MaltWhiskey/Mega-Cube/Software/LED Display/sd/Cat-meowing.jpg

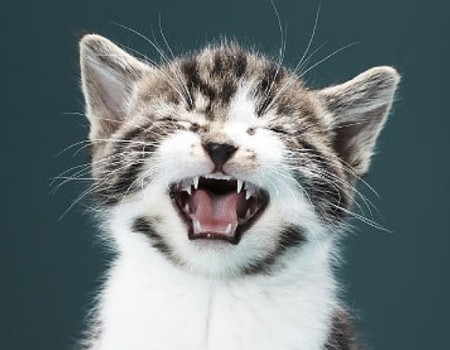
Software/LED Display/sd/Cat-meowing.jpg
