MaltWhiskey/Mega-Cube/Software/LED Display/sd/Cute-kittens.jpg

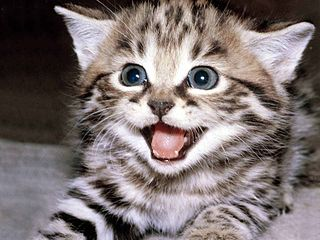
Software/LED Display/sd/Cute-kittens.jpg
