MaltWhiskey/Mega-Cube/README.md

# Mega-Cube
16x16x16 PL9823 Cube with Teensy 4.0 and FlexIO driver
https://youtu.be/ciaFar8nfHc
