MaltWhiskey/Mega-Cube/Documents/JIG.jpg

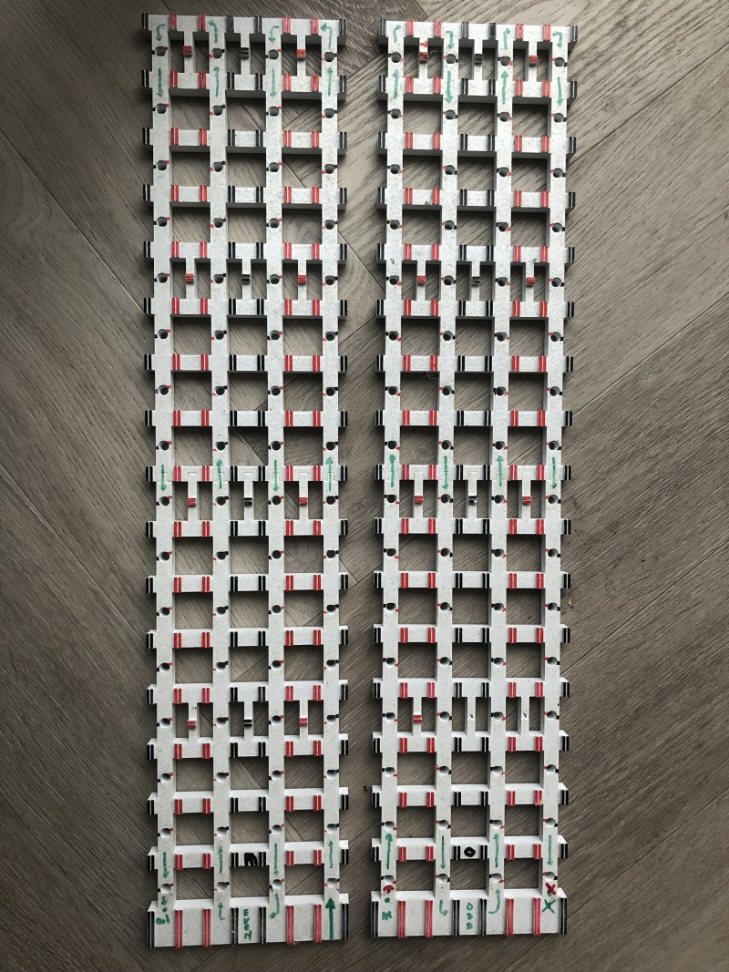
Documents/JIG.jpg
