MaltWhiskey/Mega-Cube/graphics/Sprites/Mario Sprite Sheet.png

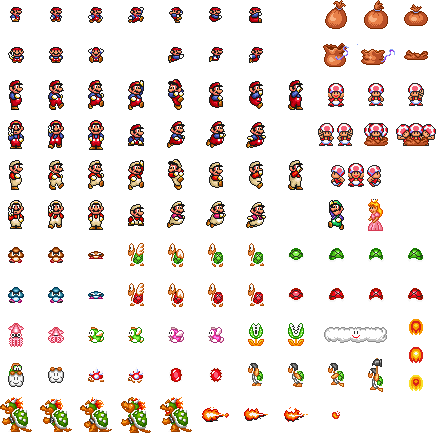
graphics/Sprites/Mario Sprite Sheet.png
