MaltWhiskey/Mega-Cube/Construction/1 Tower box.stl

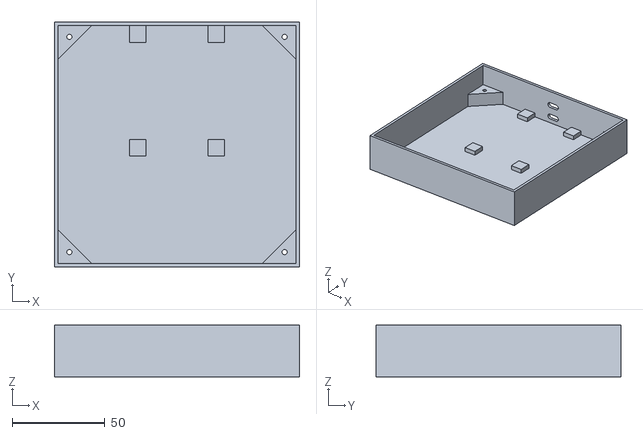
[picture p5: CAD file, 2022-07-15]
Construction/1 Tower box.stl
132.0 x 132.0 x 28.0
