MaltWhiskey/Mega-Cube/Construction/PCB.stl

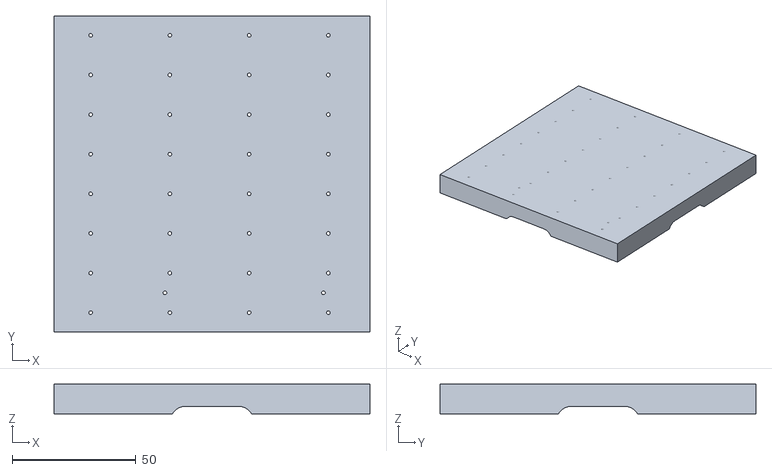
[picture p6: CAD file, 2021-11-05]
Construction/PCB.stl
127.6 x 127.6 x 12.0
