MaltWhiskey/Mega-Cube/Construction/Lid Thicker.stl

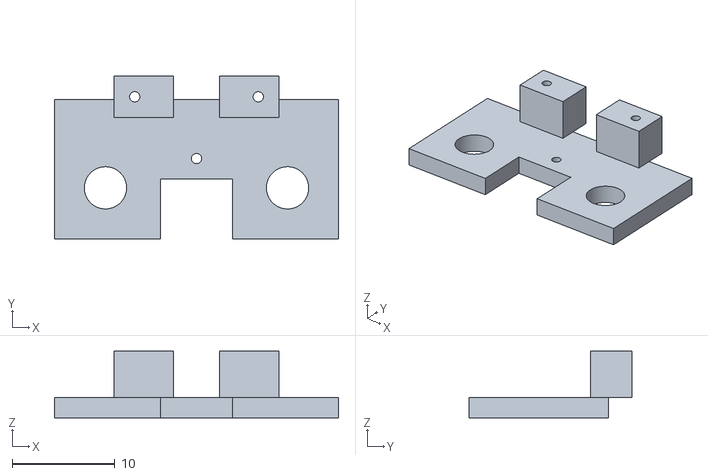
[picture p7: CAD file, 2021-11-04]
Construction/Lid Thicker.stl
27.6 x 15.8 x 6.50
