MaltWhiskey/Mega-Cube/Construction/Box Border.stl

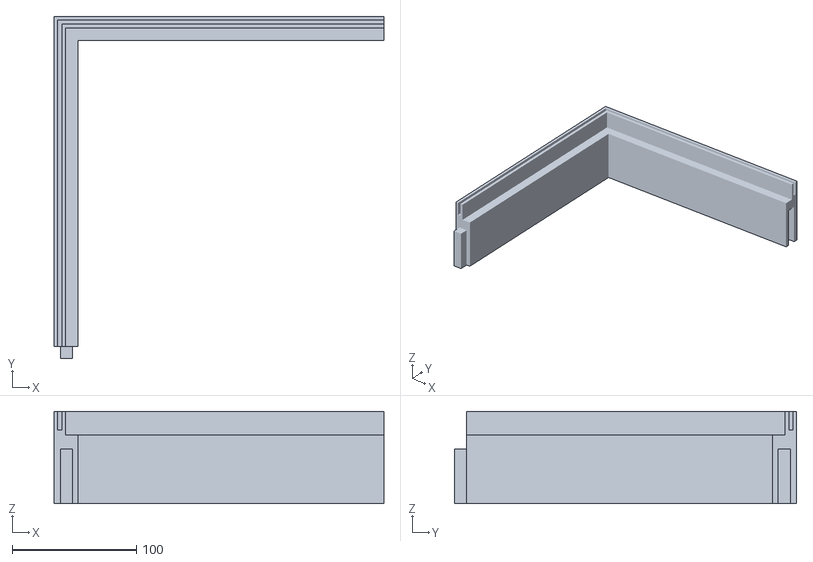
[picture p8: CAD file, 2021-11-04]
Construction/Box Border.stl
265.3 x 275.2 x 74.0
