MaltWhiskey/Mega-Cube/Construction/Clip.stl

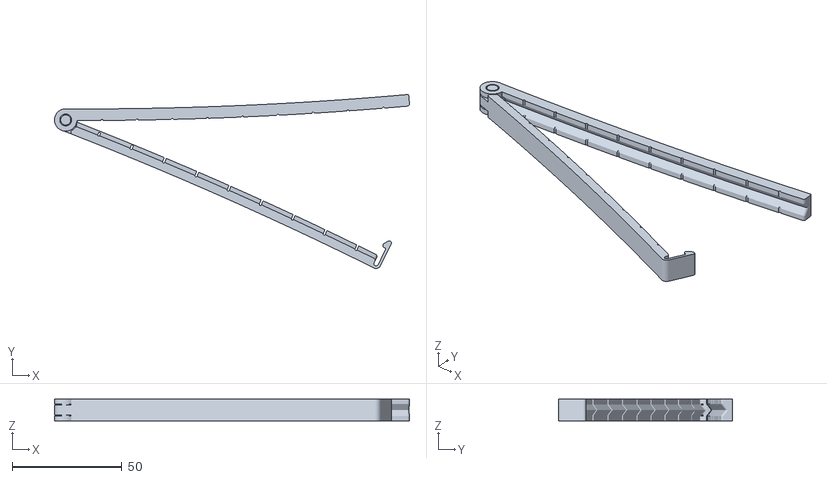
[picture p9: CAD file, 2021-11-04]
Construction/Clip.stl
161.5 x 79.1 x 10.0
