MaltWhiskey/Mega-Cube/Construction/Lid flat.stl

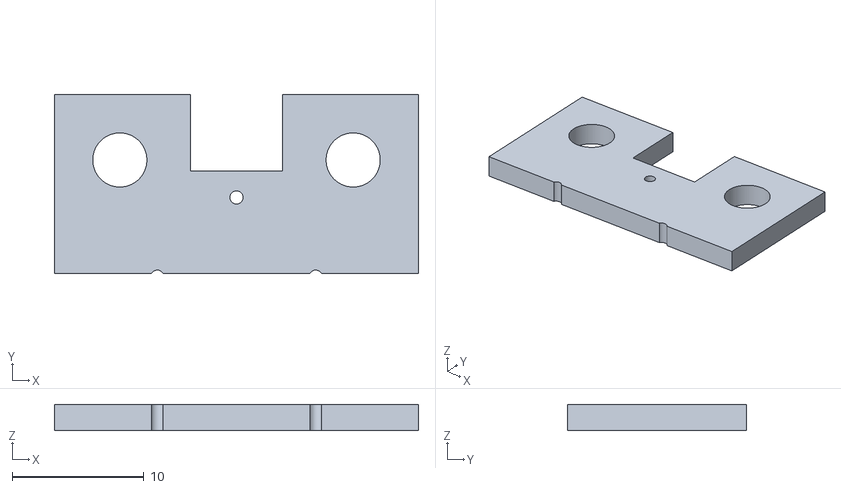
[picture p10: CAD file, 2021-11-04]
Construction/Lid flat.stl
27.6 x 13.5 x 2.00
