MaltWhiskey/Mega-Cube/Construction/Jig Bottom A.stl

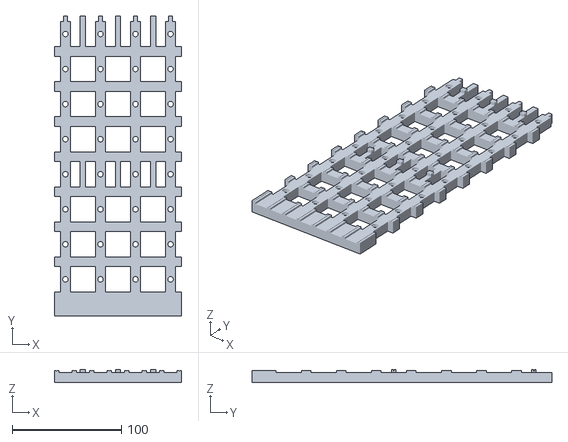
[picture p11: CAD file, 2021-11-04]
Construction/Jig Bottom A.stl
116.0 x 274.0 x 11.9
