MaltWhiskey/Mega-Cube/Construction/BendBox.stl

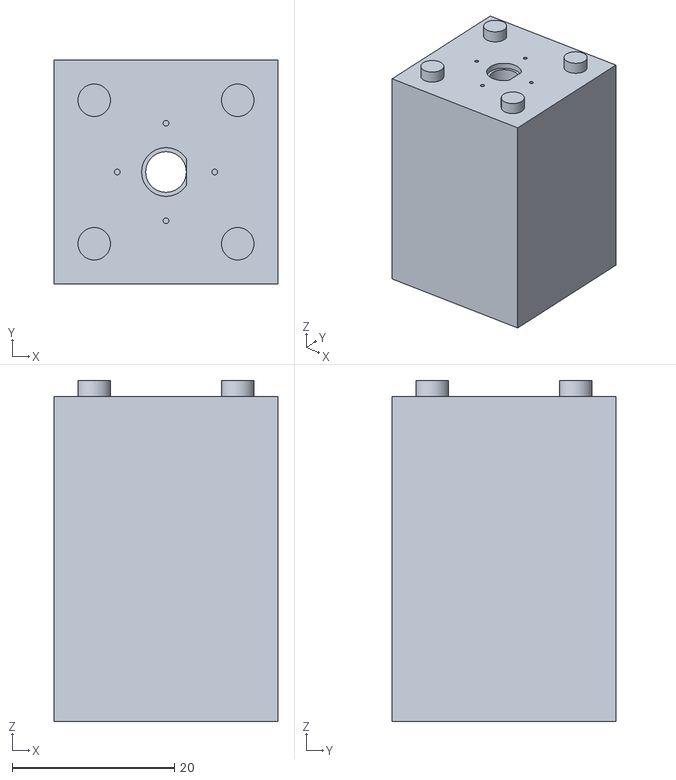
[picture p12: CAD file, 2021-11-04]
Construction/BendBox.stl
27.6 x 27.6 x 42.0
