MaltWhiskey/Mega-Cube/Construction/Jig Top A.stl

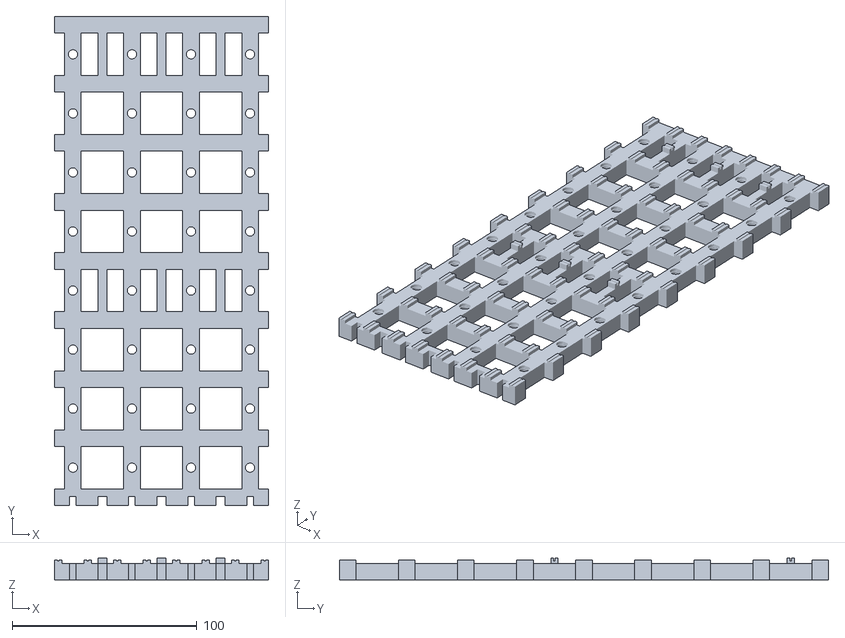
[picture p13: CAD file, 2021-11-04]
Construction/Jig Top A.stl
116.0 x 265.0 x 11.9
