MaltWhiskey/Mega-Cube/Construction/Box Border (2).stl

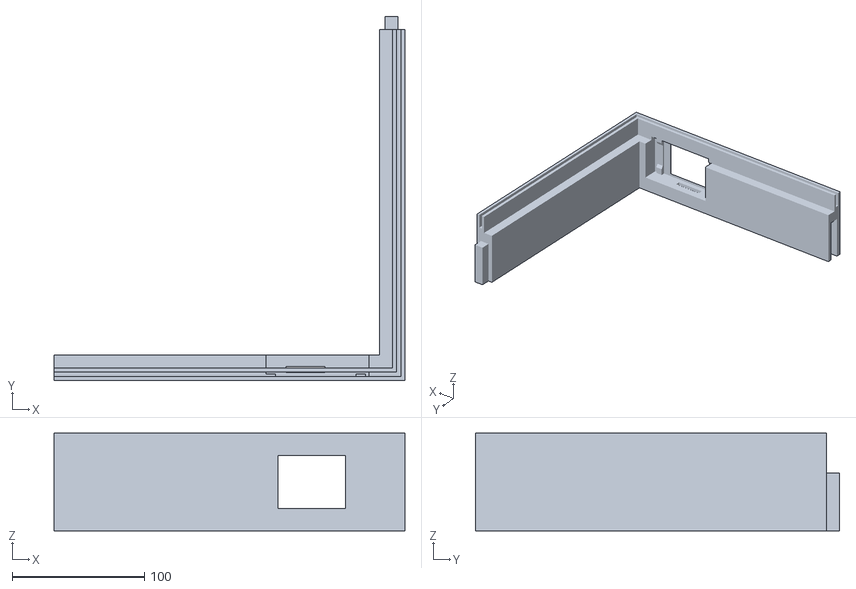
[picture p14: CAD file, 2021-11-04, an earlier design]
Construction/Box Border (2).stl
265.3 x 275.2 x 74.0
