MaltWhiskey/Mega-Cube/(list of files, cad)

Other CAD files:
Construction/Jig Bottom B.stl
Construction/Jig Top B.stl
Construction/Box Border (3).stl
Construction/Box Border (1).stl
