MaltWhiskey/Mega-Cube/Software/LED Display/todo.txt

power/Graphics.h
    look at asm for faster graphics drawing
    make a class friend of display
    fix wifi (hardware noise problem only this board)
core/LCD.*
    Implement LCD with vindar Library
    println Logging to wio terminal (noise problem)
space/
    pong scores + fading in after destruction
    clock

    ---------------------------------------
    HARDWARE:

    SOFTWARE:
        copy config from infinity, but skip json stuff.
        Pong.h needs checking
        Spectrum.h needs checking
        Cube.h is new
