MaltWhiskey/Mega-Cube/(threads)

Thread 2 (2021-11-14):

Components

TallKid420, 2021-11-14:
Can you please give me the order links to everything thanks

khan-pog, 2021-11-14:
Hello here is a couple links to what i have found for PCB components.

ESP8266:
https://core-electronics.com.au/wifi-module-esp8266-4mb.html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

Teensy-4.0:
https://core-electronics.com.au/teensy-4-0.html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

Voltage regulator:
https://www.ebay.com.au/itm/304129516747?itemid=304129516747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

2.4 inch screen and sd card.
https://www.ebay.com.au/itm/322638960113

Addressable LED WS2811:
https://de.aliexpress.com/item/32832099662.html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

TallKid420, 2021-11-14:
Thank you for sending these it helped a lot

MaltWhiskey, 2021-11-14:
Get pl9823 5mm leds not ws281x unless you first test a few and they work without capacitor.
The pcb has an assembly file, it’s in excel format for windows or numbers for ios. If you use the assembly file with assembly service the fab company will assemble the board for you with the components placed. The kicad project will also reveal all connectors and components used, there are no secrets here.
I used silvered copper wire 0.8mm, but copper will be fine too. If you don’t have a draw plate, get 0.6 or 0.65 mm instead.
12 AWG silicone wire, xt60 connectors. (Use what you like, there is only around 16A each tower so xt60 is overkill, but i like them a lot better than xt30.
The screen is ili9341 2.4”.
The connectors are for nixitube sockets, they are a bit bigger than pin headers.

If you are going to make this COOL!!!

Closed 2022-03-21.

Thread 3 (2021-11-22):

License?

firstorderexperiment, 2021-11-22:
Hello, is there a license for the code, or can you please add one?

Great work by the way. Loved the visuals on YouTube.

MaltWhiskey, 2021-11-22:
You can do whatever you want with it. There is one piece of code with Perlin Noise (you don’t have to use it) i’m not sure if there are limitations on that (i put credit in the source code) All other stuff is made by me, so enjoy!

Closed 2022-03-21.

Thread 5 (2022-01-01):

Data wire

khan-pog, 2022-01-01:
Hello, sorry for the ignorant question however here it is. Would it be okay to use 0.7mm wire as a data single wire? (I have a lot of 0.7mm wire)

MaltWhiskey, 2022-01-01:
From a signal standpoint it doesn’t matter. I used .22mm and .20mm because any thinner would break easily. But I recommend as thin as possible because it will obstruct the view through the cube a bit.

Op 1 jan. 2022 om 15:47 heeft khan-pog ***@***.***> het volgende geschreven:

Hello, sorry for the ignorant question however here it is. Would it be okay to use 0.7mm wire as a data single wire? (I have a lot of 0.7mm wire)

—
Reply to this email directly, view it on GitHub<https://github.com/MaltWhiskey/Mega-Cube/issues/5>, or unsubscribe<https://github.com/notifications/unsubscribe-auth/AKYMZ5UMWVPR5TNRAUQ6VGLUT4HYHANCNFSM5LCRYE2A>.
You are receiving this because you are subscribed to this thread.Message ID: ***@***.***>

Closed 2022-03-21.

Thread 7 (2023-08-20):

Affiliate links

brandonfake69, 2023-08-20:
I understand you don't want to provide a kit (given the huge upfront investment in the items you'd have to make) but I'd still love to get a more detailed list of items since I am quite new to the hardware stuff. On AliExpress, for instance, there are a lot of results for "pl9823". Have you considered adding affiliate links to this repo (and your YouTube channel)? At ~$400 USD for just the lights you could make a killing since people would buy stuff to make for not just this but other projects they have in mind (AliExpress has an affiliate program that pays 9%). I'd certainly buy through your links since you've been kind enough to provide this repo and videos. You could also link to the power supplies, wire, acrylic (I'd even buy a pre-made acrylic box if you link to one), the filament used to make the 3d printed parts, etc.

EDIT: I think you should put all of this links in the README.md so it's easy for people to find. You can even include links for the soldering iron, mat, wire, solder, wire cutters/crimpers, your 3d printer, etc. that you use since I don't have a lot of that stuff. Even if I don't intend to build a massive cube for my first project this helps out a newb like myself on the tools to get.

Thanks!

MaltWhiskey, 2023-08-27:
Hi Brandon?There quite a few people that made or are making my cube, so that affiliate linking may no be such a bad thing, considering it’ll help people finding the right stuff… I’ll look into it.I found some cheaper led’s than the PL9823 also more energy efficient. I have used these so i can recommend them. Here is a non affiliated link for you:https://a.aliexpress.com/_EGUFXldKind Regards,DaniëlOp 20 aug. 2023 om 03:01 heeft brandonfake69 ***@***.***> het volgende geschreven:
I understand you don't want to provide a kit (given the huge upfront investment in the items you'd have to make) but I'd still love to get a more detailed list of items since I am quite new to the hardware stuff. On AliExpress, for instance, there are a lot of results for "pl9823". Have you considered adding affiliate links to this repo (and your YouTube channel)? At ~$400 USD for just the lights you could make a killing (AliExpress has an affiliate program that pays 9%). I'd certainly buy through your links since you've been kind enough to provide this repo and videos. You could also link to the power supplies, wire, acrylic (I'd even buy a pre-made box if you link to one), the filament used to make the 3d printed parts, etc.
Thanks!

—Reply to this email directly, view it on GitHub, or unsubscribe.You are receiving this because you are subscribed to this thread.Message ID: ***@***.***>

devoh747, 2023-08-28:
The link to the LEDs didn't work for me.

On Sun, Aug 27, 2023 at 12:58 PM Malt Whiskey ***@***.***>
wrote:

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

brandonfake69, 2023-08-28:
There's a missing space. Just remove the "Kind" from the end of the URL.

brandonfake69, 2023-09-27:
Hi,
Any progress on this? I’d love to get started and give you some of that sweet sweet affiliate revenue. I tested the top hat LEDs you linked to and they seem to work great. Also, I thought I saw a comment on one of your videos about using resistors but I couldn’t see where they were used. What value and how many did you use?

MaltWhiskey, 2023-09-27:
I signed up for the affiliate program, but decided not to use it. The reason is the suppliers that i would recommend are not part of the affiliate program. So i can't generate affiliate links for them. There are suppliers that are in the affiliate program, but they are a lot more expensive and if i wouldn't buy from them myself i can't recommend them.

There are resistors on the pcb (the real one, not the 3d printed), the values/components are in the assembly file. No need to worry about them unless you make the wires to the led channels a lot longer. They are needed to suppress transients and reflections.

Althepeoplespal, 2023-11-09:
Do you recommend the round or hat version of the WS2811 leds? Are there any other changes or updates that you've done to this project that may help while I'm in the planning stages of building this cube?

Pax-IT, 2024-01-18:
Because I'm late to the party, the link: https://a.aliexpress.com/_EGUFXld does not work anymore, I'm also looking which LEDs you used. Is it possible you update your README.md and at the parts you used, not links but types and other numbers that can be helpful?

And maybe to get some revenue add a buy me coffee or patreon link.

Closed 2023-09-29.

Thread 8 (2024-02-24):

Box Border to small and Tower Box to tall

Alendres, 2024-02-24:
Hello do you can give me the cad data because the box boarder ist to small and the Tower Box ist to tall for the PCB

MaltWhiskey, 2024-02-25:
You need to glue together all 4 box borders and put the 16 pcb inside. The 1 tower box is not needed.

Op 24 feb 2024 om 20:46 heeft Alendres ***@***.***> het volgende geschreven:

Hello do you can give me the cad data because the box boarder ist to small and the Tower Box ist to tall for the PCB

—
Reply to this email directly, view it on GitHub<https://github.com/MaltWhiskey/Mega-Cube/issues/8>, or unsubscribe<https://github.com/notifications/unsubscribe-auth/AKYMZ5RD7YT3FJH6S2SDLFDYVI7SHAVCNFSM6AAAAABDYHSTUKVHI2DSMVQWIX3LMV43ASLTON2WKOZSGE2TENBWGAYDGMI>.
You are receiving this because you are subscribed to this thread.Message ID: ***@***.***>

freudecellier35, 2024-04-06:
bonjour. est t il possible d avoir les quantité de PCB a fabriquer et si vous avez un lien eventuelement pour les commander et la liste des composent et materiel a commander que j essai de construire votre cube . un grand merci car il est cool

Thread 10 (2024-04-23):

LED Tower PCB

AndrewBunn00, 2024-04-23:
Hello!
I'm making the Mega Cube currently, and would love to see some photos of the underside of one of the 16 pcb's for the towers. In the video, you show the underside of a completed one but it doesn't appear to match the final design you settled on (which the wiring is shown as a drawing right after). I'm newer to the hardware/electrical side of things, so a photo showing how things were laid out and what wire was used in the final design would be much appreciated :)

If you're curious, I've made 2 ladders of led's and am starting 2 more now. Wanting to get the first pcb finished so I can hook it up and test the first tower!
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

MaltWhiskey, 2024-04-23:
[image0.jpeg]
Using stranded wire (i think 14 awg) is much easier than solid core. Be mindful of the  isolation as to not short the circuit. You don’t need the dupont wire. Measure how long you want the wire with the xt-60 connector, it needs to get to the underside of the big aluminium plate (or what ever you used) and connect to a matching xt-60 connected to a psu.

Op 23 apr 2024 om 02:50 heeft Andrew Bunn ***@***.***> het volgende geschreven:

Hello!
I'm making the Mega Cube currently, and would love to see some photos of the underside of one of the 16 pcb's for the towers. In the video, you show the underside of a completed one but it doesn't appear to match the final design you settled on (which the wiring is shown as a drawing right after). I'm newer to the hardware/electrical side of things, so a photo showing how things were laid out and what wire was used in the final design would be much appreciated :)

If you're curious, I've made 2 ladders of led's and am starting 2 more now. Wanting to get the first pcb finished so I can hook it up and test the first tower!
IMG_1034.jpeg (view on web)<https://github.com/MaltWhiskey/Mega-Cube/assets/89755834/f99902bd-535a-4a67-9c9d-19c9fd6a0edb>

—
Reply to this email directly, view it on GitHub<https://github.com/MaltWhiskey/Mega-Cube/issues/10>, or unsubscribe<https://github.com/notifications/unsubscribe-auth/AKYMZ5W7TTVP2DIE4VWASF3Y6WV53AVCNFSM6AAAAABGTY2YSGVHI2DSMVQWIX3LMV43ASLTON2WKOZSGI2TONZQGQYDIMA>.
You are receiving this because you are subscribed to this thread.Message ID: ***@***.***>

AndrewBunn00, 2024-04-23:
It looks like the image didn't upload successfully ([image0.jpeg]). Would appreciate a reupload :) And I went with an aluminum plate as well, my goal is to follow what you did as close as possible.

MaltWhiskey, 2024-04-23:
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

MaltWhiskey, 2024-04-23:
I recommend using color coded jst rcy 2 pin connectors for the led channels (don’t use dupont). Makes sorting wires a lot easier.

Closed 2024-04-23.

Thread 13 (2025-01-17):

Allow for thicker wire in the jig

brandonfake69, 2025-01-17:
I saw in one of your YouTube comments that you thought the wire you used was too small in diameter. When I tried thicker wire it wouldn’t fit in the jigs without forcing it and therefore bending the wire. I attempted to make the wire grooves in the jig wider but it didn’t turn out well since I am not familiar with the software to do it. I thought it would be good to have that change to the jigs in the repo anyway and would like to request it. Thank you for this project!

brandonfake69, 2025-05-15:
I had ChatGPT give it a try but the outcome was [pretty funny](https://files09.oaiusercontent.com/file-72QMCpTe6ECMQEKYndBHCN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)

brandonfake69, 2025-05-15:
Grok doesn't know how to deal with .stl files. Claude gives me an error "Conversation is 3956% over the [length limit](https://support.anthropic.com/en/articles/7996848-how-large-is-claude-s-context-window). Try replacing the attached file with smaller excerpts."

Perhaps there's another LLM that is capable of it? I was hoping something like this https://www.youtube.com/watch?v=ytomieYqUCQ would work since we have an even better Gemini version available now.

MaltWhiskey, 2025-05-16:
You can do this in the slicer. Hole horizontal expansion or something similar depending on the slicer used.

Closed 2025-05-21.
