MaltWhiskey/Mega-Cube/Electronics/Mega-Cube-Board/Documents/TPS54331 WBDesign.pdf

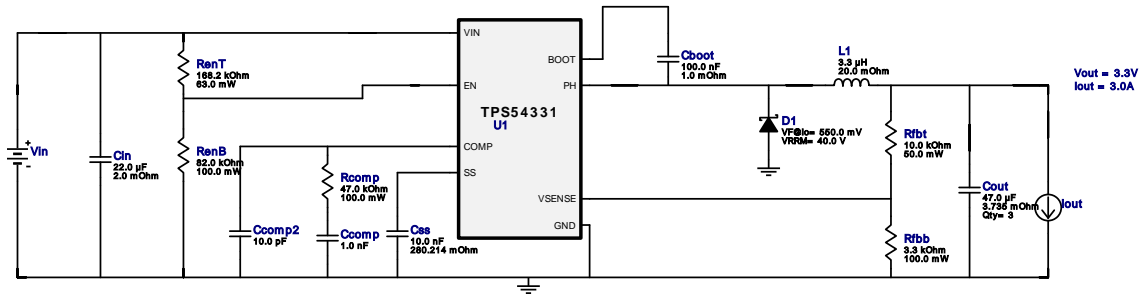
[picture p15: figure]
Css 10.0 nF 280.214 m Ohm; Ccom p2 10.0 pF; TPS5 4 3 3 1; BOOT; VIN; VSENSE; COMP; GND; Rfbb 3.3 kOhm 100.0 m W; RenB 82.0 kOhm 100.0 m W; RenT 168.2 kOhm 63.0 m W; Cboot 100.0 nF 1.0 m Ohm; Cin 22.0 µF 2.0 m Ohm; L1 3.3 µH 20.0 m Ohm; Rfbt 10.0 kOhm 50.0 m W; Cout 47.0 µF 3.735 m Ohm Qty= 3; D1 VF@Io= 550.0 m V VRRM= 40.0 V; Ccom p 1.0 nF; Rcom p 47.0 kOhm 100.0 m W; Vout = 3.3V Iout = 3.0A; Iout; Vin

Copyright © 2022, Texas Instruments Incorporated | 1 | ti.com/webench

WEBENCH®
Design Report TPS54331DDAR : TPS54331DDAR 5V-5V to 3.30V @ 3A January 6, 2022 06:47:50 GMT-06:00

## WEBENCH ® Design Report

Design : 4 TPS54331DDAR
TPS54331DDAR 5V-5V to 3.30V @ 3A

VinMin = 4.5V
VinMax = 5.5V
Vout = 3.3V
Iout = 3.0A

Device = TPS54331DDAR
Topology = Buck
Created = 2022-01-06 05:55:26.189 BOM Cost = NA
BOM Count = 16
Total Pd = 1.48W

## Electrical BOM

Name | Manufacturer | Part Number | Properties | Qty Price | Footprint
Cboot | MuRata | GRM155R71A104KA01D (http://search.murata.co.jp/Ceramy/PnsearchViewAction.do) Series= X7R | Cap= 100.0 nF ESR= 1.0 mOhm VDC= 10.0 V IRMS= 0.0 A
1 | $0.01
| | | | | 0402 3 mm²
Ccomp | MuRata | GRM1555C1H102JA01J (http://www.murata.com/products/catalog/pdf/c02e.pdf) Series= C0G/NP0

Cap= 1.0 nF
VDC= 50.0 V
IRMS= 0.0 A

1 $0.01
0402 3 mm²
Ccomp2 | MuRata | GRM0335C1H100JA01D (http://www.murata.com/products/catalog/pdf/c02e.pdf) Series= C0G/NP0

Cap= 10.0 pF
VDC= 5.0 V
IRMS= 0.0 A

1 $0.01
0201 2 mm²
Cin | MuRata | GRM32ER61C226ME20L (http://www.murata.com/products/catalog/pdf/c02e.pdf) Series= X5R

Cap= 22.0 uF
ESR= 2.0 mOhm
VDC= 16.0 V
IRMS= 3.68 A

1 $0.55
1210 15 mm²
Cout | MuRata | GRM31CR60J476ME19L (http://psearch.en.murata.com/capacitor/result/smd/?status%3Dall%26pid%3DGRM31CR60J476ME19L) Series= X5R

Cap= 47.0 uF
ESR= 3.735 mOhm
VDC= 6.3 V
IRMS= 4.091 A

3 $0.23
1206_190 11 mm²
Css | TDK | CGA1A2X7R1A103K030BA (https://product.tdk.com/en/search/capacitor/ceramic/mlcc/info?part%5Fno%3DCGA1A2X7R1A103K030BA) Series= X7R

Cap= 10.0 nF
ESR= 280.21 mOhm
VDC= 10.0 V
IRMS= 245.72 mA

1 $0.01
0201_033 2 mm²
D1 | Fairchild Semiconductor SS24FL | VF@Io= 550.0 mV
VRRM= 40.0 V

1 $0.05
SOD-123F 12 mm²
L1 | TDK | VLP8040T-3R3N | L= 3.3 µH 20.0 mOhm
1 | $0.22

VLP8040 113 mm²
Rcomp | Yageo | RC0603FR-0747KL (http://www.yageo.com/documents/recent/PYu%2DRC0603%5F51%5FRoHS%5FL%5F7.pdf) Series= ? | Res= 47.0 kOhm Power= 100.0 mW Tolerance= 1.0%
1 | $0.01
0603 5 mm²
RenB | Yageo | RC0603FR-0782KL (http://www.yageo.com/documents/recent/PYu%2DRC0603%5F51%5FRoHS%5FL%5F7.pdf) Series= ? | Res= 82.0 kOhm Power= 100.0 mW Tolerance= 1.0%
1 | $0.01
0603 5 mm²
RenT | CUSTOM | CUSTOM Series= CRCW..e3 | Res= 168.2 kOhm Power= 63.0 mW Tolerance= 1.0%
1 | NA
0402 0 mm²

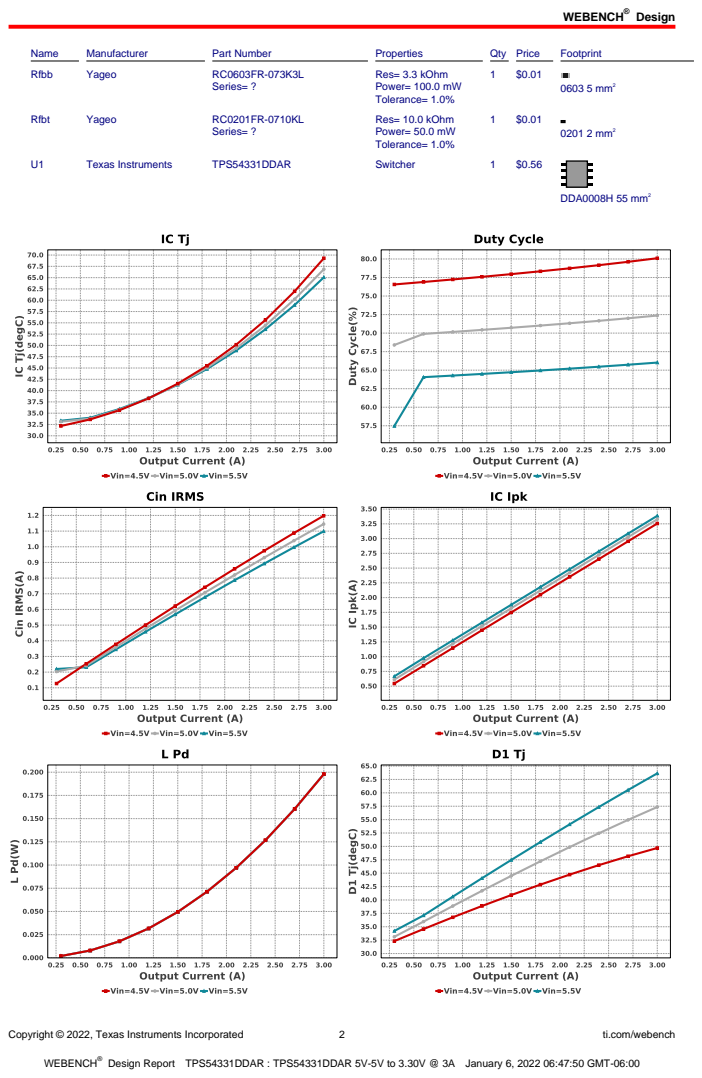
[picture p16: page 2]
Design; Copyright © 2022, Texas Instruments Incorporated; ti.com/webench; Name; Manufacturer; Part Number; Properties; Qty Price; Footprint; Rfbb; Yageo; Series= ?; Res= 3.3 kOhm Power= 100.0 mW Tolerance= 1.0%; 0603 5 mm²; Rfbt; Res= 10.0 kOhm Power= 50.0 mW Tolerance= 1.0%; 0201 2 mm²; Texas Instruments; TPS54331DDAR; Switcher; DDA0008H 55 mm²

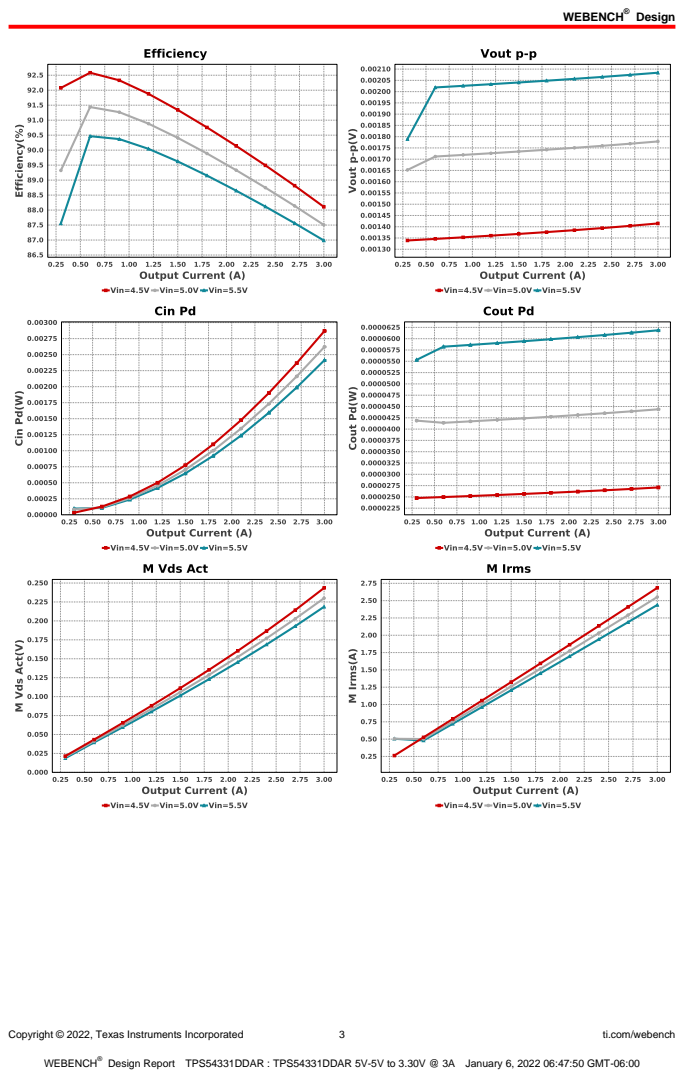
[picture p17: page 3]
Copyright © 2022, Texas Instruments Incorporated; ti.com/webench

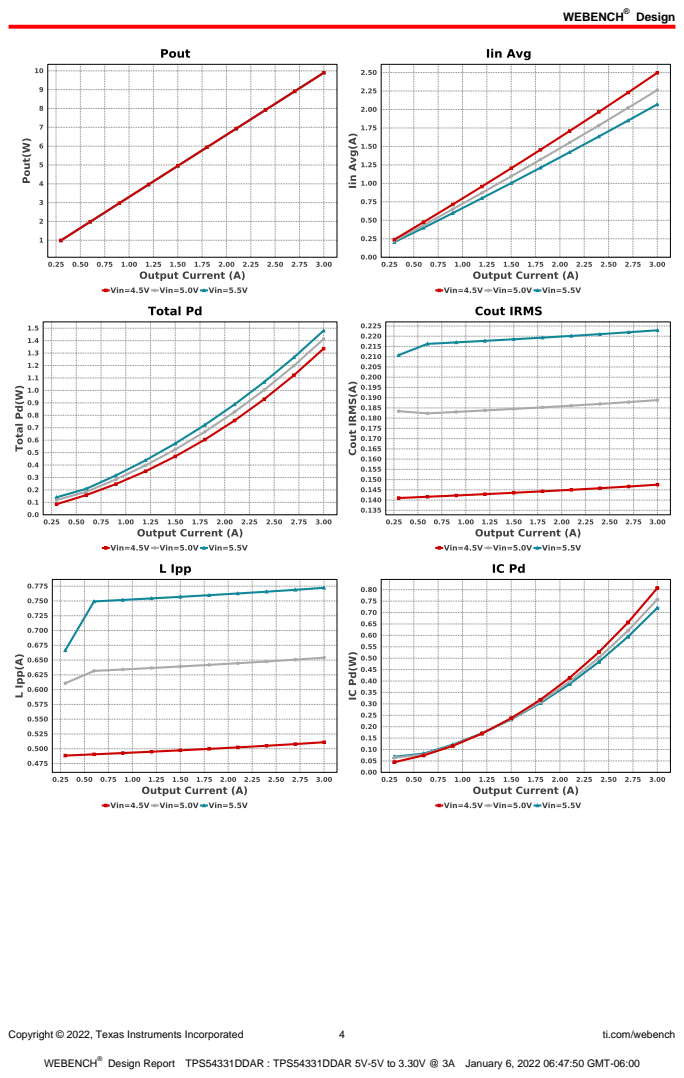
[picture p18: page 4]
Copyright © 2022, Texas Instruments Incorporated; ti.com/webench

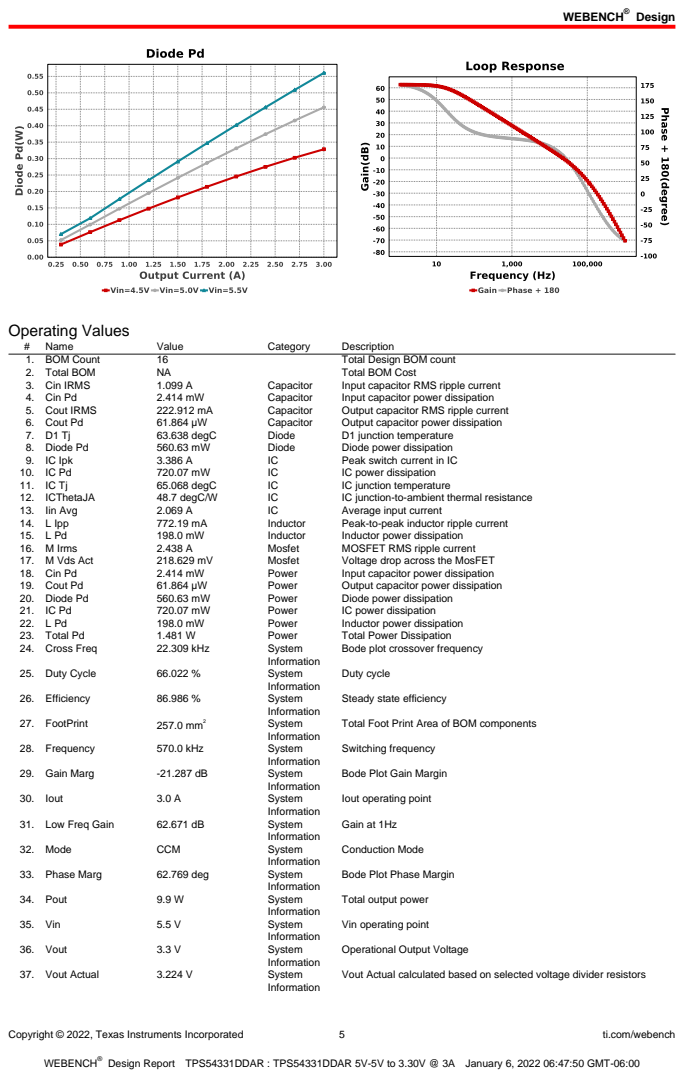
[picture p19: page 5]
Copyright © 2022, Texas Instruments Incorporated; ti.com/webench; Operating Values; Name; Value; Category; Description; 1. BOM Count; Total Design BOM count; 2. Total BOM; Total BOM Cost; 3. Cin IRMS; Capacitor; Input capacitor RMS ripple current; 4. Cin Pd; Input capacitor power dissipation; 5. Cout IRMS; Output capacitor RMS ripple current; 6. Cout Pd; Output capacitor power dissipation; 63.638 degC; Diode; D1 junction temperature; 8. Diode Pd; Diode power dissipation; 9. IC Ipk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

Bode plot crossover frequency

Steady state efficiency

Total Foot Print Area of BOM components

Bode Plot Gain Margin

Iout operating point

Bode Plot Phase Margin

Total output power

Vin operating point

Operational Output Voltage

Vout Actual calculated based on selected voltage divider resistors

Copyright © 2022, Texas Instruments Incorporated | 6 | ti.com/webench
# | Name | Value | Category | Description

38. Vout Tolerance | 5.072 % | System
| | | Information | Vout Tolerance based on IC Tolerance (no load) and voltage divider resistors if applicable
39. Vout p-p | 2.084 mV | System
| | | Information | Peak-to-peak output ripple voltage

## Design Inputs

Name | Value | Description
Iout | 3.0 | Maximum Output Current
SoftStart | 4.0 ms | Soft Start Time (ms)
VinMax | 5.5 | Maximum input voltage
VinMin | 4.5 | Minimum input voltage
Vout | 3.3 | Output Voltage
| base_pn | | TPS54331 | Base Product Number
source | DC | Input Source Type
Ta | 30.0 | Ambient temperature


Copyright © 2022, Texas Instruments Incorporated | 7 | ti.com/webench

## Assembly

## Component Testing

Some published data on components in datasheets such as Capacitor ESR and Inductor DC resistance is based on conservative values that will guarantee that the components always exceed the specification. For design purposes it is usually better to work with typical values. Since this data is not always available it is a good practice to measure the Capacitance and ESR values of Cin and Cout, and the inductance and DC resistance of L1 before assembly of the board. Any large discrepancies in values should be electrically simulated in WEBENCH to check for instabilities and thermally simulated in WebTHERM to make sure critical temperatures are not exceeded.

## Soldering Component to Board

If board assembly is done in house it is best to tack down one terminal of a component on the board then solder the other terminal. For surface mount parts with large tabs, such as the DPAK, the tab on the back of the package should be pre-tinned with solder, then tacked into place by one of the pins. To solder the tab town to the board place the iron down on the board while resting against the tab, heating both surfaces simultaneously. Apply light pressure to the top of the plastic case until the solder flows around the part and the part is flush with the PCB. If the solder is not flowing around the board you may need a higher wattage iron (generally 25W to 30W is enough).

## Initial Startup of Circuit

It is best to initially power up the board by setting the input supply voltage to the lowest operating input voltage 4.5V and set the input supply's current limit to zero. With the input supply off connect up the input supply to Vin and GND. Connect a digital volt meter and a load if needed to set the minimum Iout of the design from Vout and GND. Turn on the input supply and slowly turn up the current limit on the input supply. If the voltage starts to rise on the input supply continue increasing the input supply current limit while watching the output voltage. If the current increases on the input supply, but the voltage remains near zero, then there may be a short or a component misplaced on the board. Power down the board and visually inspect for solder bridges and recheck the diode and capacitor polarities. Once the power supply circuit is operational then more extensive testing may include full load testing, transient load and line tests to compare with simulation results.

## Load Testing

The setup is the same as the initial startup, except that an additional digital voltmeter is connected between Vin and GND, a load is connected between Vout and GND and a current meter is connected in series between Vout and the load. The load must be able to handle at least rated output power + 50% ( 7.5 watts for this design). Ideally the load is supplied in the form of a variable load test unit. It can also be done in the form of suitably large power resistors. When using an oscilloscope to measure waveforms on the prototype board, the ground leads of the oscilloscope probes should be as short as possible and the area of the loop formed by the ground lead should be kept to a minimum. This will help reduce ground lead inductance and eliminate EMI noise that is not actually present in the circuit.

## WEBENCH® Electrical Simulation Report

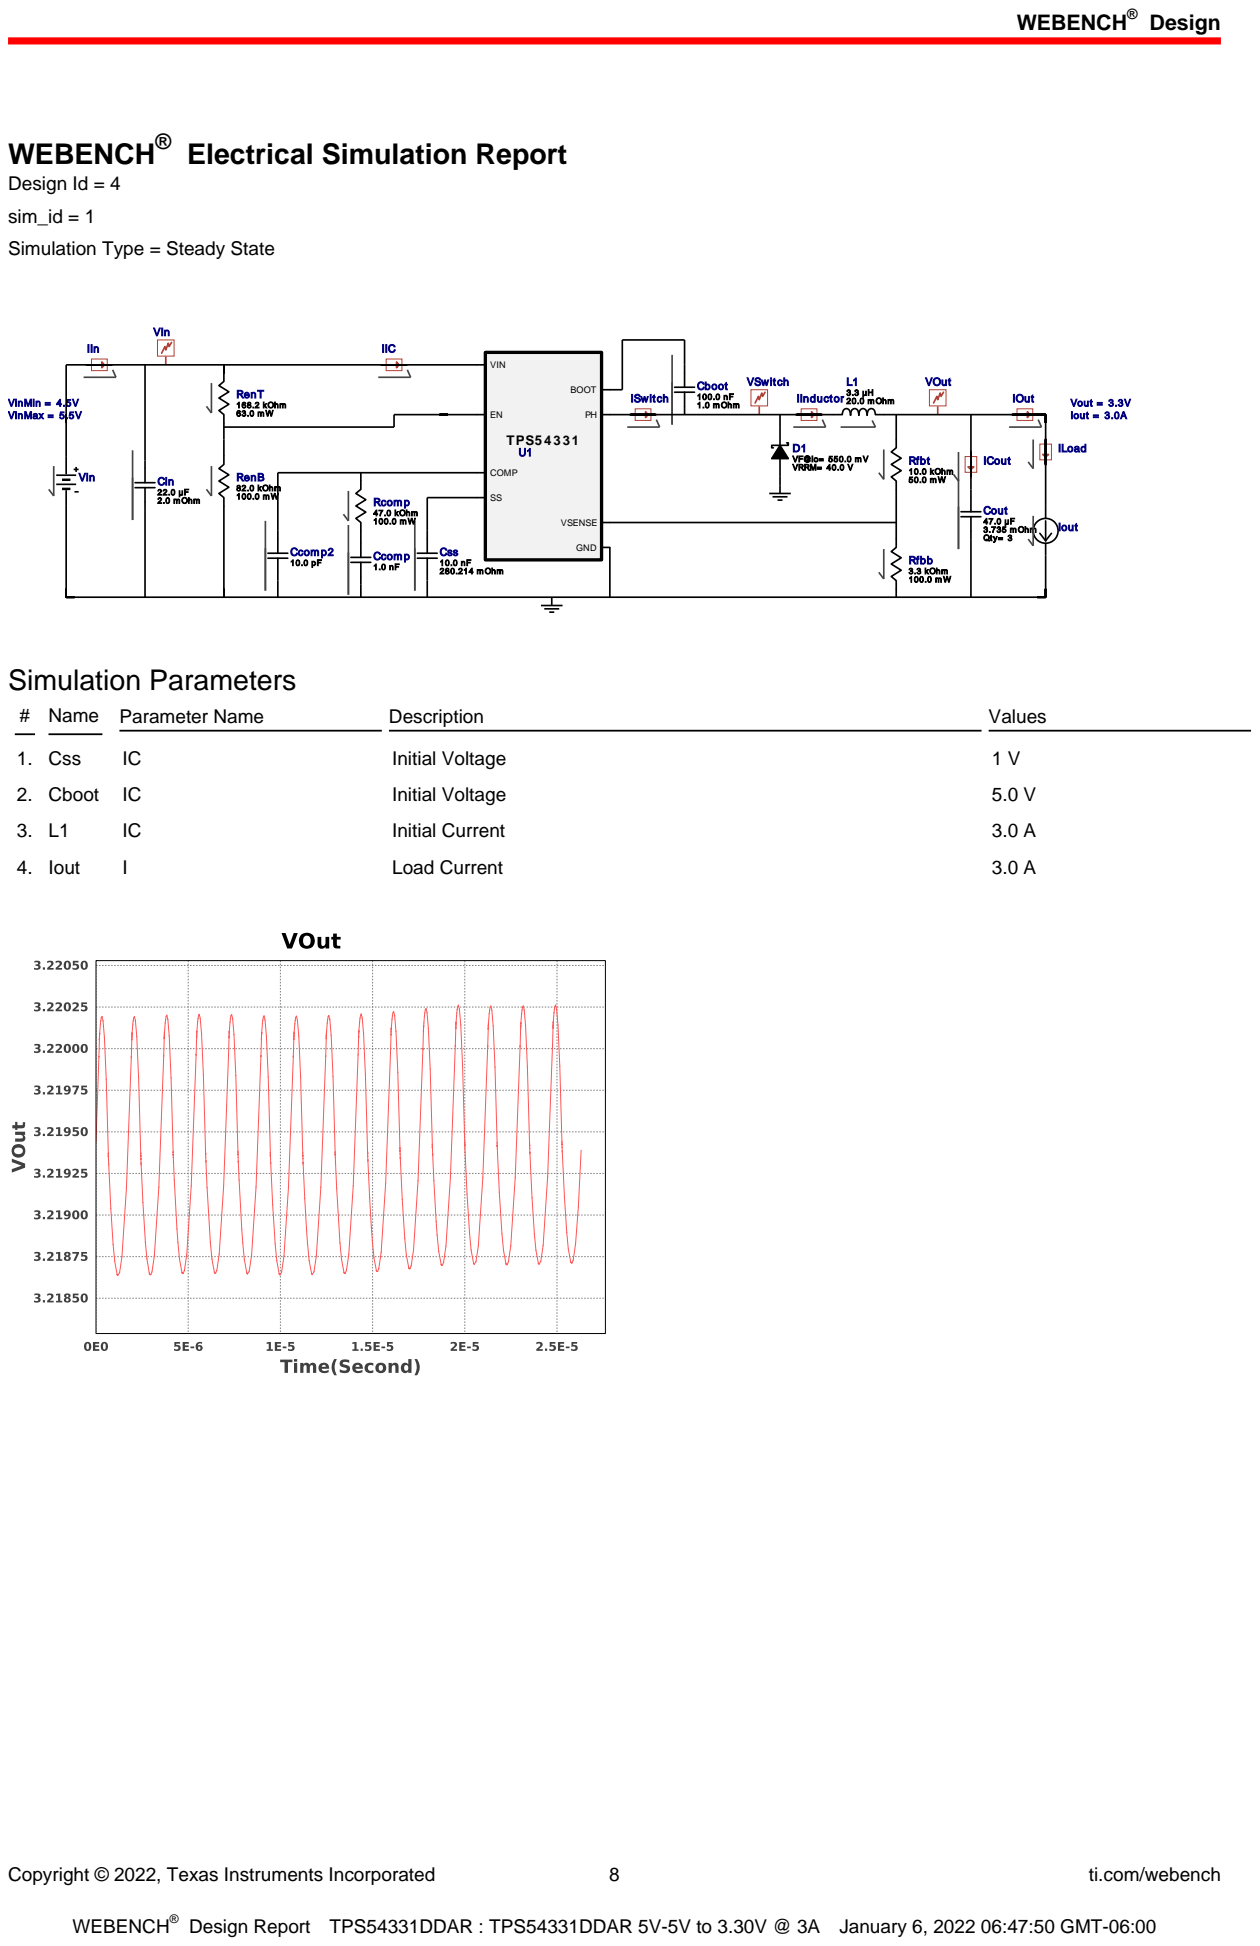
[picture p21: page 8]
Copyright © 2022, Texas Instruments Incorporated; ti.com/webench; Css 10.0 nF 280.214 m Ohm; VinMin = 4.5V VinMax = 5.5V; VIn; ISwitch; VSwitch; ICout; Ccom p2 10.0 pF; TPS5 4 3 3 1; BOOT; VIN; VSENSE; COMP; GND; Rfbb 3.3 kOhm 100.0 m W; RenB 82.0 kOhm 100.0 m W; RenT 168.2 kOhm 63.0 m W; Cboot 100.0 nF; 1.0 m Ohm; IInductor; IIC; Cin 22.0 µF 2.0 m Ohm; L1 3.3 µH 20.0 m Ohm; Rfbt 10.0 kOhm 50.0 m W; IOut; Cout 47.0 µF 3.735 m Ohm Qty= 3; IIn; D1 VF@Io= 550.0 m V VRRM= 40.0 V; Ccom p 1.0 nF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

Design Id = 4
sim_id = 1
Simulation Type = Steady State

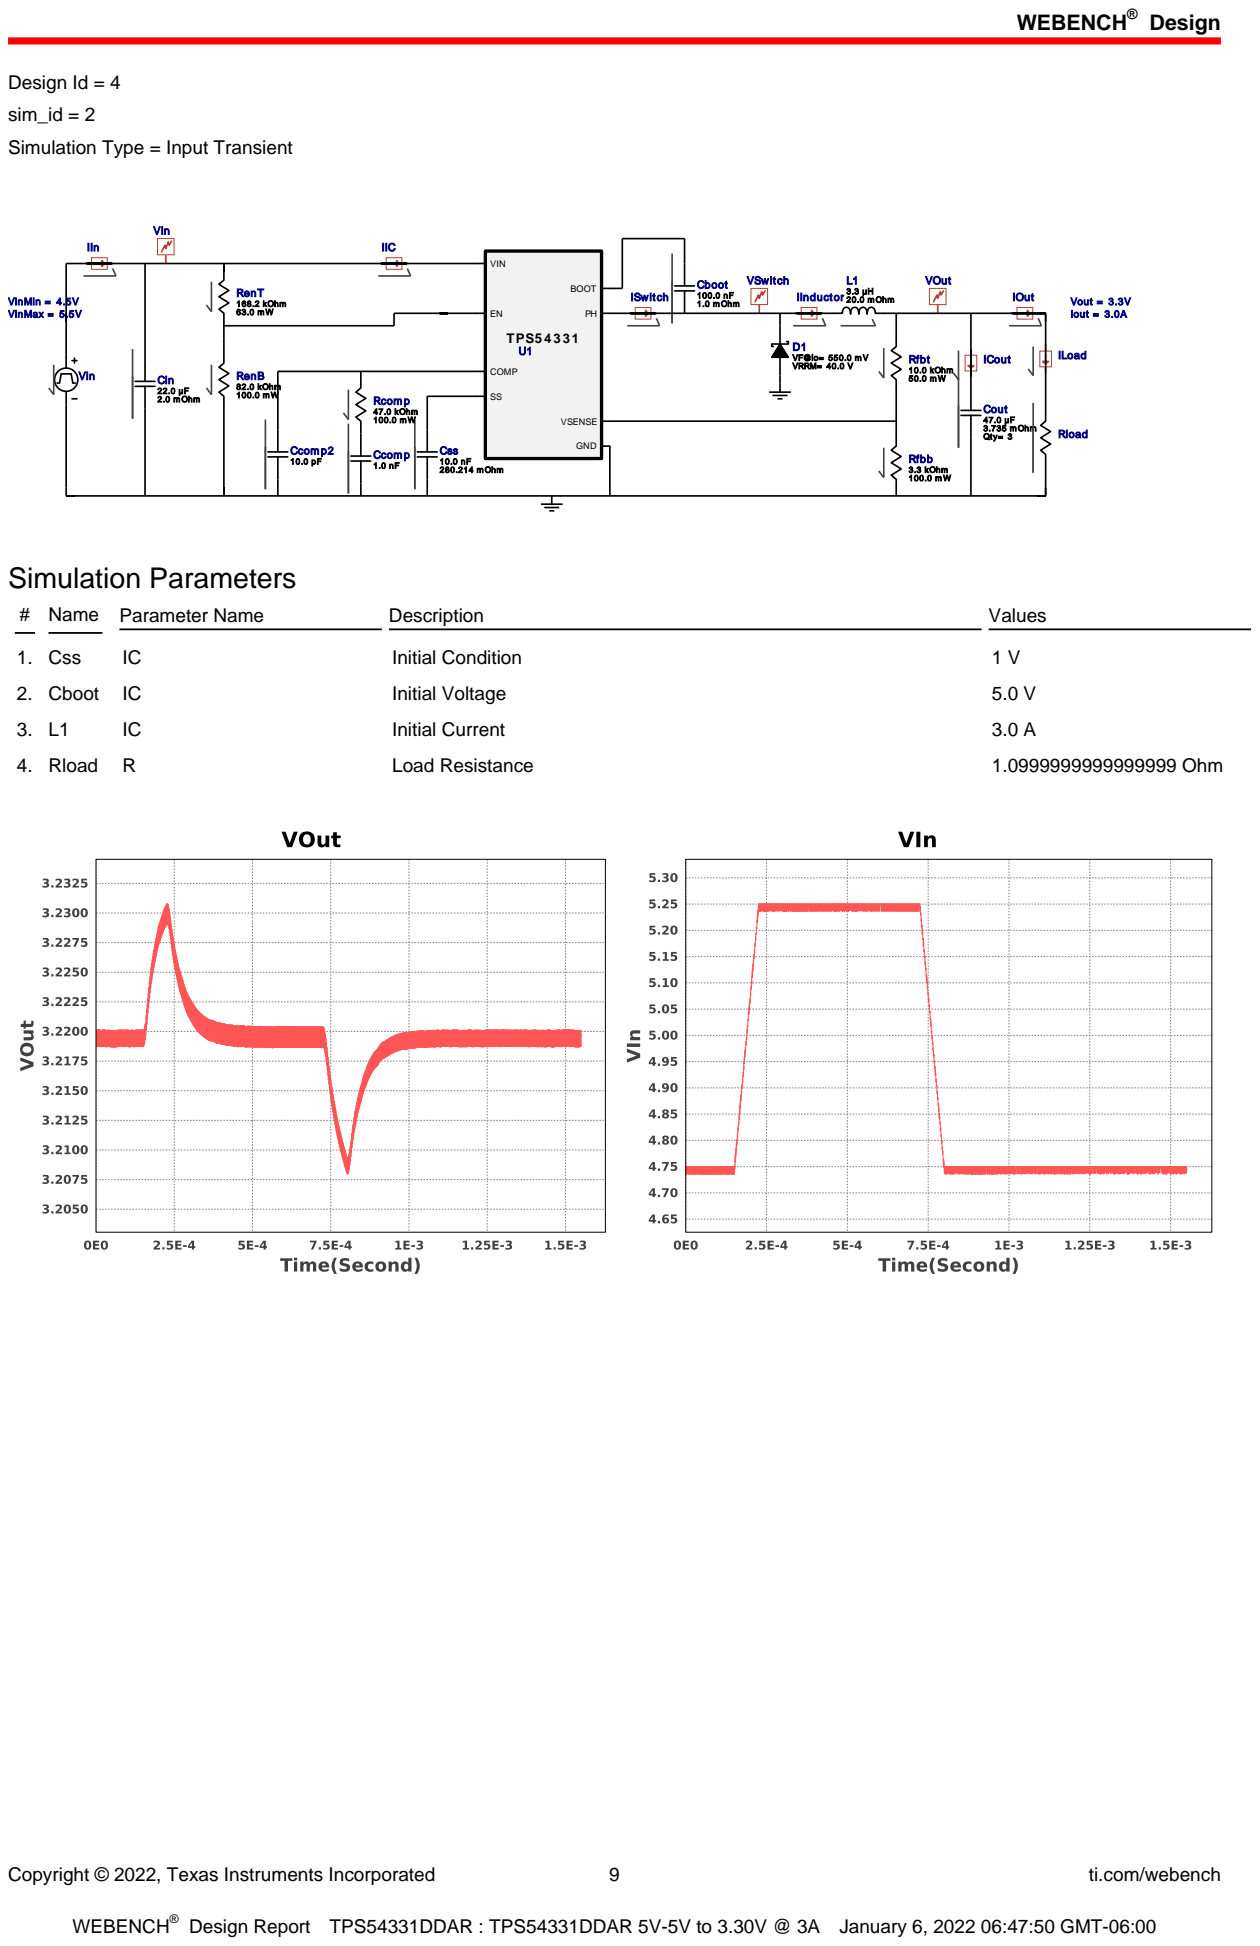
[picture p22: page 9]
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

Design Id = 4
sim_id = 2
Simulation Type = Input Transient

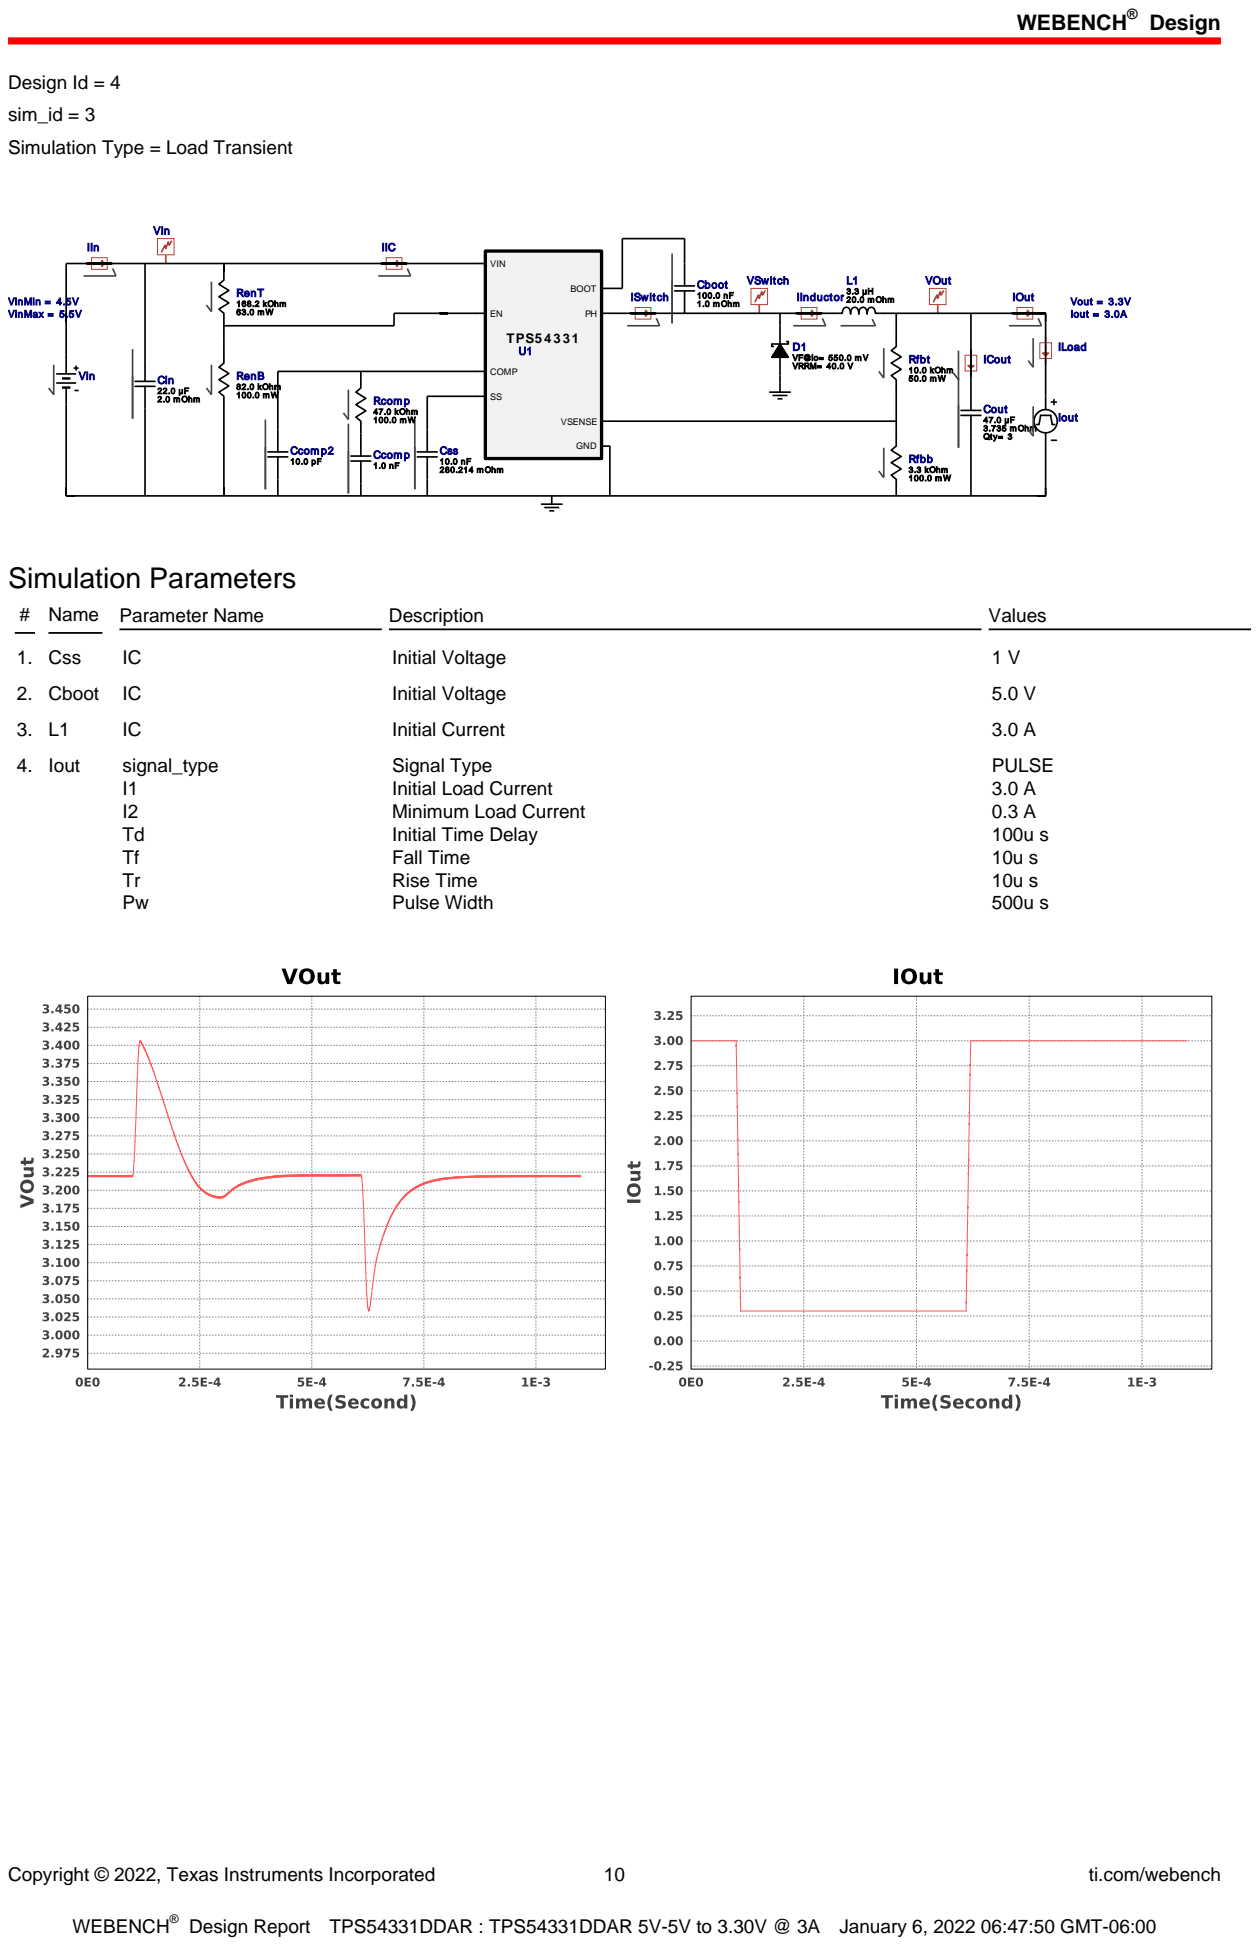
[picture p23: page 10]
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

Design Id = 4
sim_id = 3
Simulation Type = Load Transient

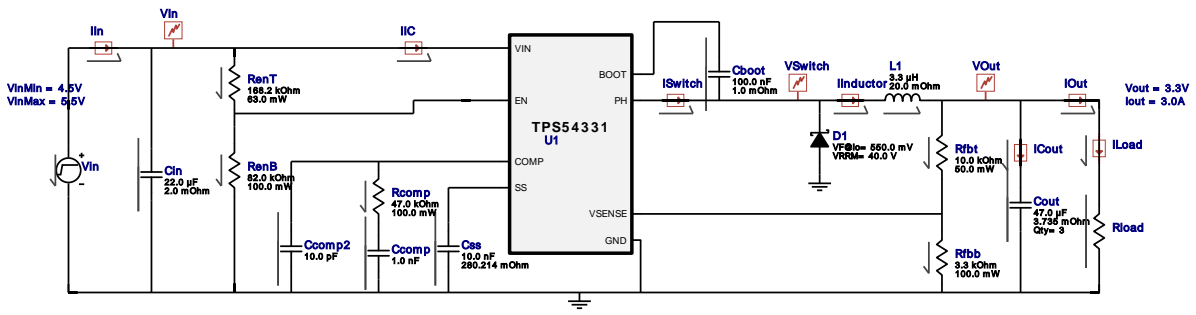
[picture p24: figure]
Css 10.0 nF 280.214 m Ohm; VinMin = 4.5V VinMax = 5.5V; VIn; ISwitch; VSwitch; ICout; Ccom p2 10.0 pF; TPS5 4 3 3 1; BOOT; VIN; VSENSE; COMP; GND; Rfbb 3.3 kOhm 100.0 m W; RenB 82.0 kOhm 100.0 m W; RenT 168.2 kOhm 63.0 m W; Cboot 100.0 nF; 1.0 m Ohm; IInductor; IIC; Cin 22.0 µF 2.0 m Ohm; L1 3.3 µH 20.0 m Ohm; Rfbt 10.0 kOhm 50.0 m W; IOut; Cout 47.0 µF 3.735 m Ohm Qty= 3; IIn; D1 VF@Io= 550.0 m V VRRM= 40.0 V; Ccom p 1.0 nF; Rcom p 47.0 kOhm 100.0 m W; Vout = 3.3V Iout = 3.0A; VOut; ILoad; Rload; Vin
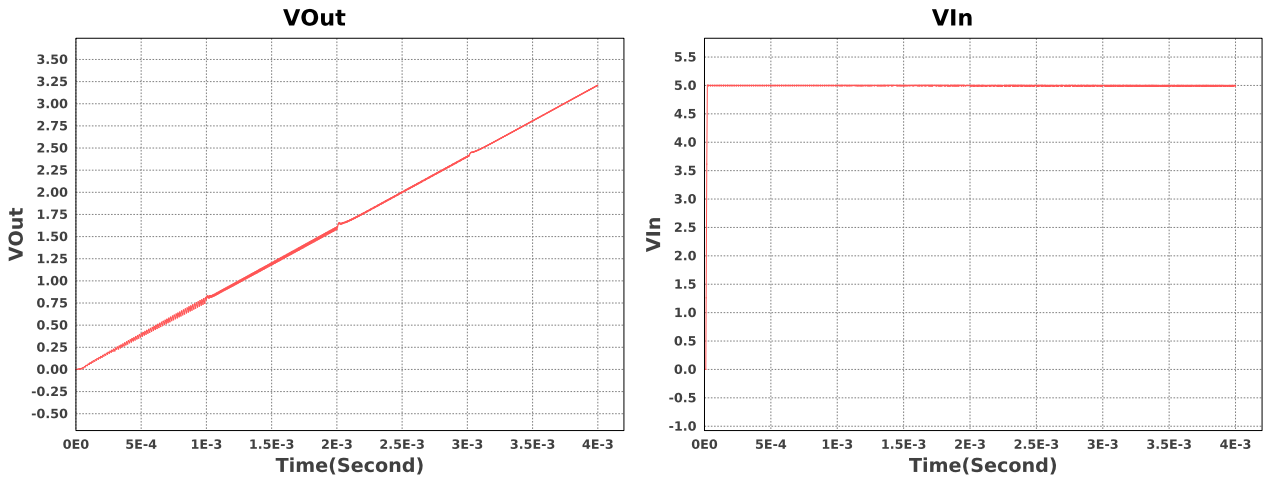
[picture p25: figure]

Copyright © 2022, Texas Instruments Incorporated | 11 | ti.com/webench

Design Id = 4
sim_id = 4
Simulation Type = Startup

## Simulation Parameters

# Name Parameter Name | Description | Values

1. Rload R | Load Resistance | 1.0999999999999999 Ohm

## Design Assistance

1. Master key : CB899E537F3BB804[v1]
2. TPS54331 Product Folder : http://www.ti.com/product/TPS54331 : contains the data sheet and other resources.

Important Notice and Disclaimer

TI provides technical and reliability data (including datasheets), design resources (including reference designs), application or other design advice, web tools, safety information, and other resources AS IS and with all faults, and disclaims all warranties. These resources are intended for skilled developers designing with TI products. You are solely responsible for (1) selecting the appropriate TI products for your application, (2) designing, validating and testing your application, and (3) ensuring your application meets applicable standards, and any other safety, security, or other requirements.

These resources are subject to change without notice. TI grants you permission to use these resources only for development of an application that uses the TI products described in the resource. Other reproduction and display of these resources is prohibited. No license is granted to any other TI intellectual property right or to any third party intellectual property right. TI disclaims responsibility for, and you will fully indemnify TI and its representatives against, any claims, damages, costs, losses, and liabilities arising out of your use of these resources.

Providing these resources does not expand or otherwise alter TI's applicable Terms of Sale or other applicable terms available either on ti.com or provided in conjunction with TI products.
