MaltWhiskey/Mega-Cube/Electronics/Mega-Cube-Board/Mega-Cube-Board.kicad_pcb

## KiCad design Electronics/Mega-Cube-Board/Mega-Cube-Board.kicad_pcb (2022-07-15)

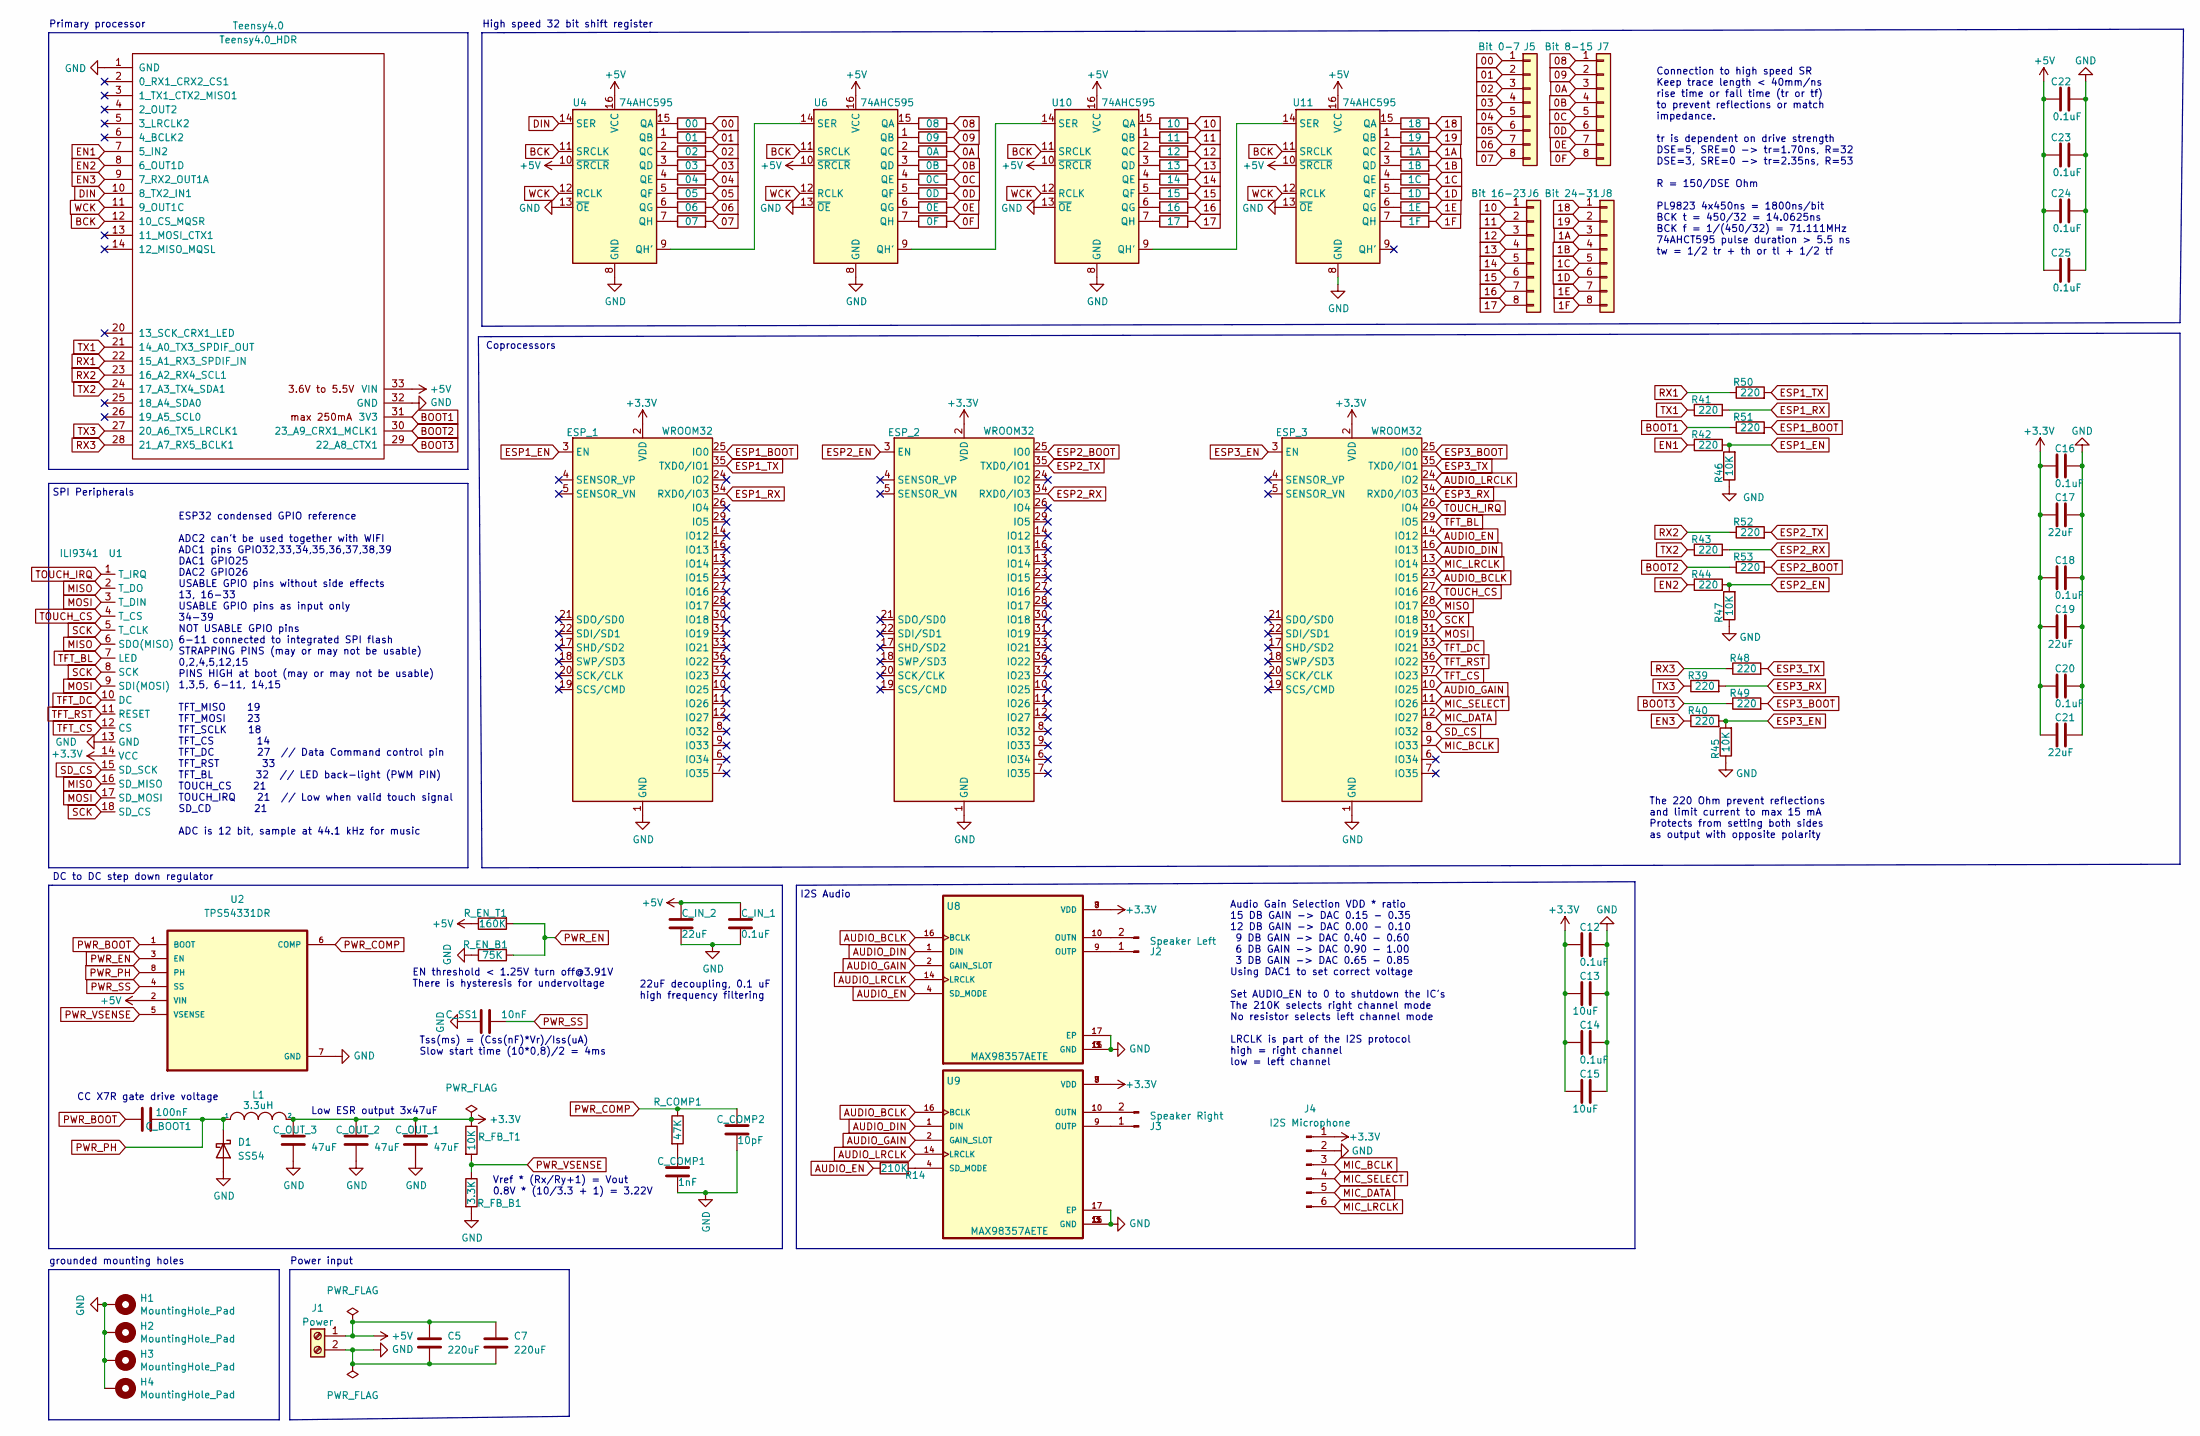
[picture p26: schematic Mega-Cube-Board.kicad_sch, Mega Cube Board]

Parts:
C5, C7: 220uF; CP_Radial_D8.0mm_P2.50mm
C12, C14: 0.1uF; C_0402_1005Metric; LCSC Part C307331
C13, C15: 10uF; C_0402_1005Metric; LCSC Part C15525
C16, C18, C20, C22, C23, C24, C25: 0.1uF; C_0603_1608Metric; LCSC Part C14663
C17, C19, C21: 22uF; C_0603_1608Metric; LCSC Part C59461
C_BOOT1: 100nF; C_0603_1608Metric; LCSC Part C14663
C_COMP1: 1nF; C_0603_1608Metric; LCSC Part C1588
C_COMP2: 10pF; C_0603_1608Metric; LCSC Part C1634
C_IN_1: 0.1uF; C_1206_3216Metric; LCSC Part C24497
C_IN_2: 22uF; C_1206_3216Metric; LCSC Part C12891
C_OUT_1, C_OUT_2, C_OUT_3: 47uF; C_1206_3216Metric; LCSC Part C96123
C_SS1: 10nF; C_0603_1608Metric; LCSC Part C57112
D1: SS54; D_SMA; LCSC Part C22452
ESP_1, ESP_2, ESP_3: WROOM32; ESP32-WROOM-32; LCSC Part C82899
H1, H2, H3, H4: MountingHole_Pad; MountingHole_3.2mm_M3_Pad_Via
J1: Power; TerminalBlock_bornier-2_P5.08mm
J2: Speaker Left; JST_XH_B2B-XH-A_1x02_P2.50mm_Vertical
J3: Speaker Right; JST_XH_B2B-XH-A_1x02_P2.50mm_Vertical
J4: I2S Microphone; JST_XH_B6B-XH-A_1x06_P2.50mm_Vertical
J5: Bit 0-7; JST_XH_B8B-XH-A_1x08_P2.50mm_Vertical
J6: Bit 16-23; JST_XH_B8B-XH-A_1x08_P2.50mm_Vertical
J7: Bit 8-15; JST_XH_B8B-XH-A_1x08_P2.50mm_Vertical
J8: Bit 24-31; JST_XH_B8B-XH-A_1x08_P2.50mm_Vertical
L1: 3.3uH; L_Sunltech_SLO0630H_7.1x6.6mm; LCSC Part C207839
R6, R7, R8, R9, R10, R11, R12, R13, R15, R16, R17, R18, R19, R20, R21, R22, R23, R24, R25, R26, R27, R28, R29, R30, R31, R32, R33, R34, R35, R36, R37, R38, R39, R40, R41, R42, R43, R44, R48, R49, R50, R51, R52, R53: 220; R_0402_1005Metric; LCSC Part C25091
R14: 210K; R_0402_1005Metric; LCSC Part C25767
R45, R46, R47: 10K; R_0402_1005Metric; LCSC Part C25744
R_COMP1: 47K; R_0603_1608Metric; LCSC Part C25819
R_EN_B1: 75K; R_0603_1608Metric; LCSC Part C23242
R_EN_T1: 160K; R_0603_1608Metric; LCSC Part C22813
R_FB_B1: 3.3K; R_0603_1608Metric; LCSC Part C22978
R_FB_T1: 10K; R_0603_1608Metric; LCSC Part C25804
Teensy4.0: Teensy4.0_HDR; Teensy40hdr
U1: ILI9341; ILI9341 2.4 TFT
U2: TPS54331DR; SOIC127P599X175-8N; LCSC Part C9865
U4, U6, U10, U11: 74AHC595; SOIC-16_3.9x9.9mm_P1.27mm; LCSC Part C133793
U8, U9: MAX98357AETE; QFN50P300X300X80-17N; LCSC Part C910544

Connections:
00: J5.1, R6.2
0A: J7.3, R17.2
0B: J7.4, R18.2
0C: J7.5, R19.2
0D: J7.6, R20.2
0E: J7.7, R21.2
0F: J7.8, R22.2
01: J5.2, R7.2
1A: J8.3, R33.2
1B: J8.4, R34.2
1C: J8.5, R35.2
1D: J8.6, R36.2
1E: J8.7, R37.2
1F: J8.8, R38.2
02: J5.3, R8.2
03: J5.4, R9.2
04: J5.5, R10.2
05: J5.6, R11.2
06: J5.7, R12.2
07: J5.8, R13.2
08: J7.1, R15.2
09: J7.2, R16.2
10: J6.1, R23.2
11: J6.2, R24.2
12: J6.3, R25.2
13: J6.4, R26.2
14: J6.5, R27.2
15: J6.6, R28.2
16: J6.7, R29.2
17: J6.8, R30.2
18: J8.1, R31.2
19: J8.2, R32.2
+3V3: C12.2, C13.2, C14.2, C15.2, C16.2, C17.2, C18.2, C19.2, C20.2, C21.2, C_OUT_1.1, C_OUT_2.1, C_OUT_3.1, ESP_1.2 (VDD), ESP_2.2 (VDD), ESP_3.2 (VDD), J4.1, L1.2, R_FB_T1.1, U1.14 (VCC), U8.7 (VDD), U8.8 (VDD), U9.7 (VDD), U9.8 (VDD)
+5V: C5.1, C7.1, C22.1, C23.1, C24.1, C25.1, C_IN_1.1, C_IN_2.1, J1.1, R_EN_T1.1, Teensy4.0.33 (VIN), U2.2 (VIN), U4.10 (~SRCLR), U4.16 (VCC), U6.10 (~SRCLR), U6.16 (VCC), U10.10 (~SRCLR), U10.16 (VCC), U11.10 (~SRCLR), U11.16 (VCC)
AUDIO_BCLK: ESP_3.23 (IO15), U8.16 (BCLK), U9.16 (BCLK)
AUDIO_DIN: ESP_3.16 (IO13), U8.1 (DIN), U9.1 (DIN)
AUDIO_EN: ESP_3.14 (IO12), R14.1, U8.4 (SD_MODE)
AUDIO_GAIN: ESP_3.10 (IO25), U8.2 (GAIN_SLOT), U9.2 (GAIN_SLOT)
AUDIO_LRCLK: ESP_3.24 (IO2), U8.14 (LRCLK), U9.14 (LRCLK)
BCK: Teensy4.0.12 (10_CS_MQSR), U4.11 (SRCLK), U6.11 (SRCLK), U10.11 (SRCLK), U11.11 (SRCLK)
BOOT1: R51.1, Teensy4.0.31 (3V3)
BOOT2: R53.1, Teensy4.0.30 (23_A9_CRX1_MCLK1)
BOOT3: R49.1, Teensy4.0.29 (22_A8_CTX1)
DIN: Teensy4.0.10 (8_TX2_IN1), U4.14 (SER)
EN1: R42.1, Teensy4.0.7 (5_IN2)
EN2: R44.1, Teensy4.0.8 (6_OUT1D)
EN3: R40.1, Teensy4.0.9 (7_RX2_OUT1A)
ESP1_BOOT: ESP_1.25 (IO0), R51.2
ESP1_EN: ESP_1.3 (EN), R42.2, R46.2
ESP1_RX: ESP_1.34 (RXD0/IO3), R41.2
ESP1_TX: ESP_1.35 (TXD0/IO1), R50.2
ESP2_BOOT: ESP_2.25 (IO0), R53.2
ESP2_EN: ESP_2.3 (EN), R44.2, R47.2
ESP2_RX: ESP_2.34 (RXD0/IO3), R43.2
ESP2_TX: ESP_2.35 (TXD0/IO1), R52.2
ESP3_BOOT: ESP_3.25 (IO0), R49.2
ESP3_EN: ESP_3.3 (EN), R40.2, R45.2
ESP3_RX: ESP_3.34 (RXD0/IO3), R39.2
ESP3_TX: ESP_3.35 (TXD0/IO1), R48.2
GND: C5.2, C7.2, C12.1, C13.1, C14.1, C15.1, C16.1, C17.1, C18.1, C19.1, C20.1, C21.1, C22.2, C23.2, C24.2, C25.2, C_COMP1.2, C_COMP2.2, C_IN_1.2, C_IN_2.2, C_OUT_1.2, C_OUT_2.2, C_OUT_3.2, C_SS1.1, D1.2 (A), ESP_1.1 (GND), ESP_1.15 (GND), ESP_1.38 (GND), ESP_1.39 (GND), ESP_2.1 (GND), ESP_2.15 (GND), ESP_2.38 (GND), ESP_2.39 (GND), ESP_3.1 (GND), ESP_3.15 (GND), ESP_3.38 (GND), ESP_3.39 (GND), H1.1, H2.1, H3.1, H4.1, J1.2, J4.2, R45.1, R46.1, R47.1, R_EN_B1.1, R_FB_B1.2, Teensy4.0.1 (GND), Teensy4.0.32 (GND), U1.13 (GND), U2.7 (GND), U4.8 (GND), U4.13 (~OE), U6.8 (GND), U6.13 (~OE), U8.3 (GND), U8.11 (GND), U8.15 (GND), U8.17 (EP), U9.3 (GND), U9.11 (GND), U9.15 (GND), U9.17 (EP), U10.8 (GND), U10.13 (~OE), U11.8 (GND), U11.13 (~OE)
MIC_BCLK: ESP_3.9 (IO33), J4.3
MIC_DATA: ESP_3.12 (IO27), J4.5
MIC_LRCLK: ESP_3.13 (IO14), J4.6
MIC_SELECT: ESP_3.11 (IO26), J4.4
MISO: ESP_3.28 (IO17), U1.2 (T_DO), U1.6 (SDO(MISO)), U1.16 (SD_MISO)
MOSI: ESP_3.31 (IO19), U1.3 (T_DIN), U1.9 (SDI(MOSI)), U1.17 (SD_MOSI)
unnamed: C_COMP1.1, R_COMP1.2
unnamed: J2.1, U8.9 (OUTP)
unnamed: J2.2, U8.10 (OUTN)
unnamed: J3.1, U9.9 (OUTP)
unnamed: J3.2, U9.10 (OUTN)
unnamed: R6.1, U4.15 (QA)
unnamed: R7.1, U4.1 (QB)
unnamed: R8.1, U4.2 (QC)
unnamed: R9.1, U4.3 (QD)
unnamed: R10.1, U4.4 (QE)
unnamed: R11.1, U4.5 (QF)
unnamed: R12.1, U4.6 (QG)
unnamed: R13.1, U4.7 (QH)
unnamed: R14.2, U9.4 (SD_MODE)
unnamed: R15.1, U6.15 (QA)
unnamed: R16.1, U6.1 (QB)
unnamed: R17.1, U6.2 (QC)
unnamed: R18.1, U6.3 (QD)
unnamed: R19.1, U6.4 (QE)
unnamed: R20.1, U6.5 (QF)
unnamed: R21.1, U6.6 (QG)
unnamed: R22.1, U6.7 (QH)
unnamed: R23.1, U10.15 (QA)
unnamed: R24.1, U10.1 (QB)
unnamed: R25.1, U10.2 (QC)
unnamed: R26.1, U10.3 (QD)
unnamed: R27.1, U10.4 (QE)
unnamed: R28.1, U10.5 (QF)
unnamed: R29.1, U10.6 (QG)
unnamed: R30.1, U10.7 (QH)
unnamed: R31.1, U11.15 (QA)
unnamed: R32.1, U11.1 (QB)
unnamed: R33.1, U11.2 (QC)
unnamed: R34.1, U11.3 (QD)
unnamed: R35.1, U11.4 (QE)
unnamed: R36.1, U11.5 (QF)
unnamed: R37.1, U11.6 (QG)
unnamed: R38.1, U11.7 (QH)
unnamed: U4.9 (QH'), U6.14 (SER)
unnamed: U10.9 (QH'), U11.14 (SER)
unnamed: U6.9 (QH'), U10.14 (SER)
PWR_BOOT: C_BOOT1.1, U2.1 (BOOT)
PWR_COMP: C_COMP2.1, R_COMP1.1, U2.6 (COMP)
PWR_EN: R_EN_B1.2, R_EN_T1.2, U2.3 (EN)
PWR_PH: C_BOOT1.2, D1.1 (K), L1.1, U2.8 (PH)
PWR_SS: C_SS1.2, U2.4 (SS)
PWR_VSENSE: R_FB_B1.1, R_FB_T1.2, U2.5 (VSENSE)
RX1: R50.1, Teensy4.0.22 (15_A1_RX3_SPDIF_IN)
RX2: R52.1, Teensy4.0.23 (16_A2_RX4_SCL1)
RX3: R48.1, Teensy4.0.28 (21_A7_RX5_BCLK1)
SCK: ESP_3.30 (IO18), U1.5 (T_CLK), U1.8 (SCK), U1.18 (SD_CS)
SD_CS: ESP_3.8 (IO32), U1.15 (SD_SCK)
TFT_BL: ESP_3.29 (IO5), U1.7 (LED)
TFT_CS: ESP_3.37 (IO23), U1.12 (CS)
TFT_DC: ESP_3.33 (IO21), U1.10 (DC)
TFT_RST: ESP_3.36 (IO22), U1.11 (RESET)
TOUCH_CS: ESP_3.27 (IO16), U1.4 (T_CS)
TOUCH_IRQ: ESP_3.26 (IO4), U1.1 (T_IRQ)
TX1: R41.1, Teensy4.0.21 (14_A0_TX3_SPDIF_OUT)
TX2: R43.1, Teensy4.0.24 (17_A3_TX4_SDA1)
TX3: R39.1, Teensy4.0.27 (20_A6_TX5_LRCLK1)
WCK: Teensy4.0.11 (9_OUT1C), U4.12 (RCLK), U6.12 (RCLK), U10.12 (RCLK), U11.12 (RCLK)

Notes on the sheet:
CC X7R gate drive voltage
SPI Peripherals
22uF decoupling, 0.1 uF high frequency filtering
ESP32 condensed GPIO reference ADC2 can't be used together with WIFI ADC1 pins GPIO32,33,34,35,36,37,38,39 DAC1 GPIO25 DAC2 GPIO26 USABLE GPIO pins without side effects 13, 16-33 USABLE GPIO pins as input only 34-39 NOT USABLE GPIO pins 6-11 connected to integrated SPI flash STRAPPING PINS (may or 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
Vref * (Rx/Ry+1) = Vout 0.8V * (10/3.3 + 1) = 3.22V
High speed 32 bit shift register
Power input
DC to DC step down regulator
Connection to high speed SR Keep trace length < 40mm/ns rise time or fall time (tr or tf) to prevent reflections or match impedance. tr is dependent on drive strength DSE=5, SRE=0 -> tr=1.70ns, R=32 DSE=3, SRE=0 -> tr=2.35ns, R=53 R = 150/DSE Ohm PL9823 4x450ns = 1800ns/bit BCK t = 450/32 = 14.0625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
The 220 Ohm prevent reflections and limit current to max 15 mA Protects from setting both sides as output with opposite polarity
grounded mounting holes
Tss(ms) = (Css(nF)*Vr)/Iss(uA) Slow start time (10*0,8)/2 = 4ms
EN threshold < 1.25V turn off@3.91V There is hysteresis for undervoltage
Audio Gain Selection VDD * ratio 15 DB GAIN -> DAC 0.15 - 0.35 12 DB GAIN -> DAC 0.00 - 0.10 9 DB GAIN -> DAC 0.40 - 0.60 6 DB GAIN -> DAC 0.90 - 1.00 3 DB GAIN -> DAC 0.65 - 0.85 Using DAC1 to set correct voltage Set AUDIO_EN to 0 to shutdown the IC's The 210K selects right channel mode No resisto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
Primary processor
Low ESR output 3x47uF
Coprocessors
I2S Audio

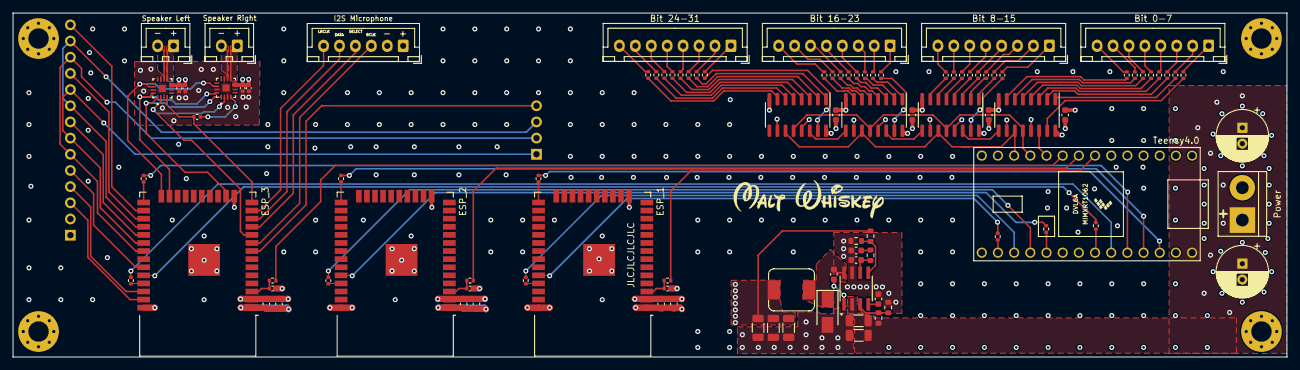
[picture p27: board Mega-Cube-Board.kicad_pcb from above]

Board: 4 copper layers, 200.0 x 54.0 mm, 104 parts (0 on the bottom side), 128 nets.
