MaltWhiskey/Mega-Cube/Electronics/32Bit shift register v2/32Bit shift register.kicad_pcb

## KiCad design Electronics/32Bit shift register v2/32Bit shift register.kicad_pcb (2020-12-27)

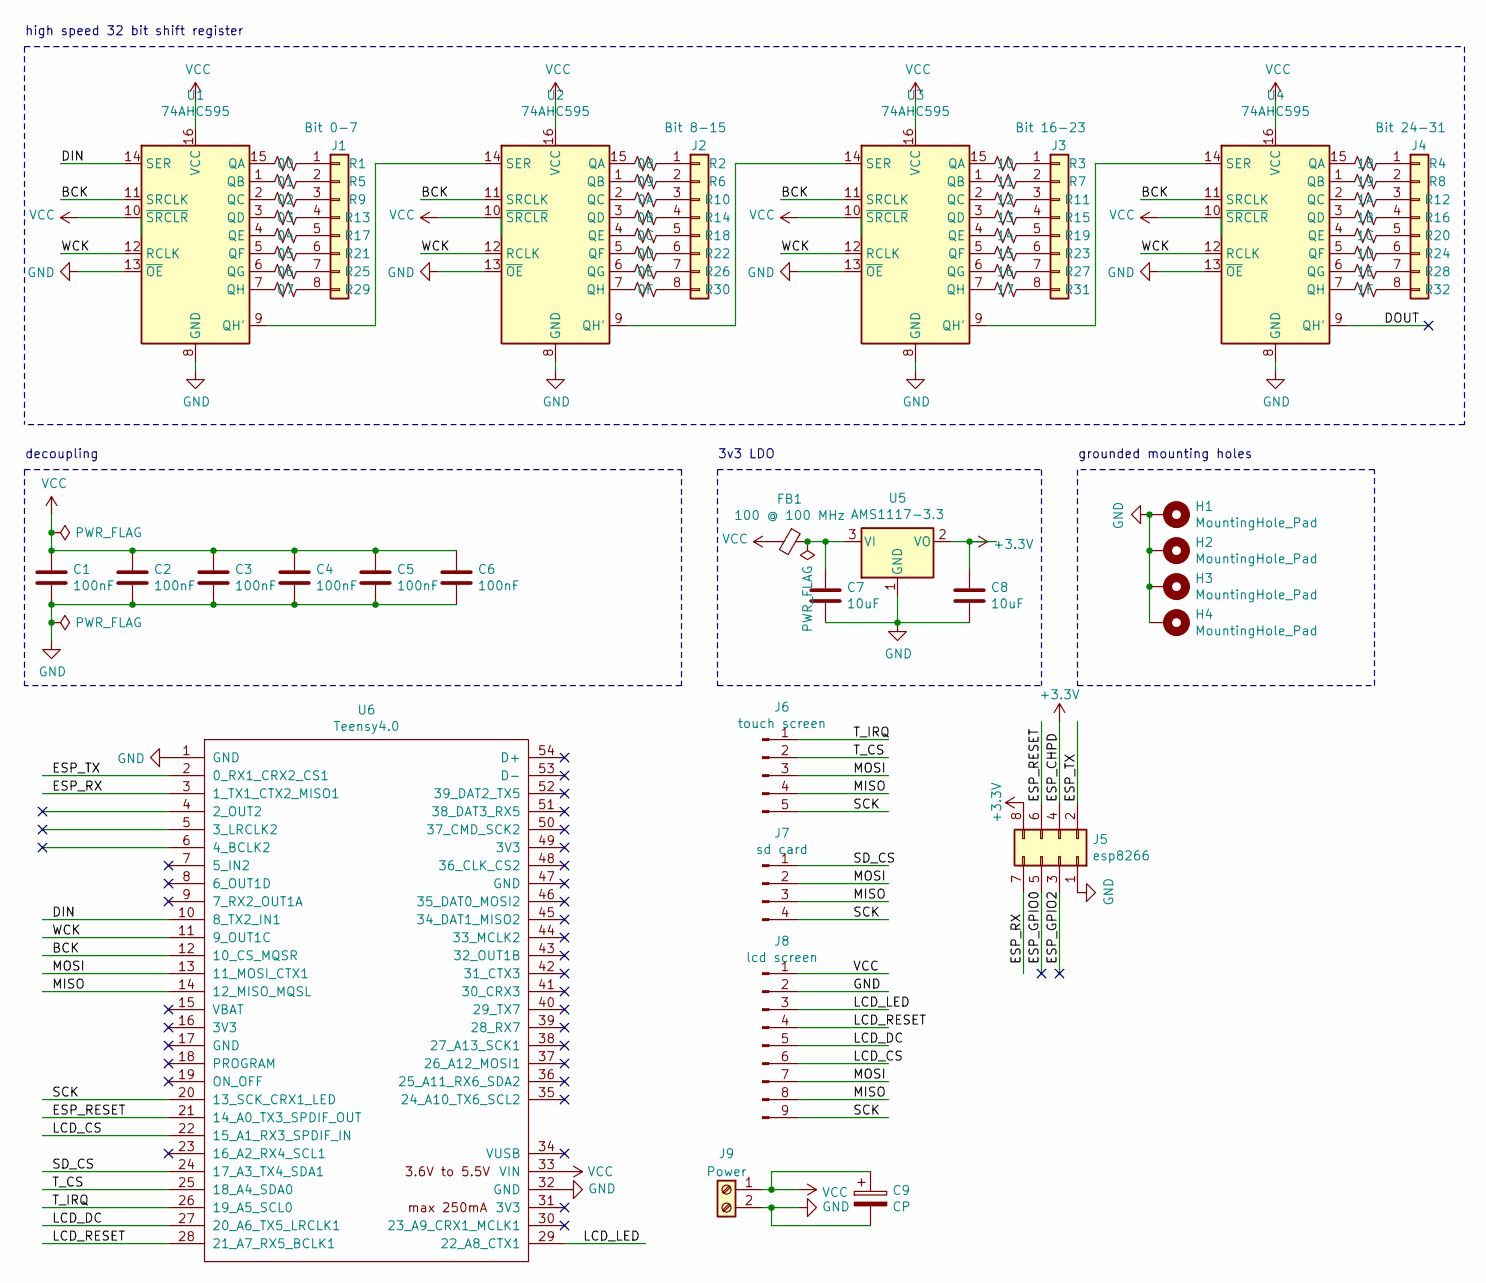
[picture p28: schematic 32Bit shift register.sch, High speed 32 Bit Shift register]

Parts:
C1, C2, C3, C4, C5, C6: 100nF; C_0603_1608Metric
C7, C8: 10uF; C_0603_1608Metric
C9: CP; CP_Radial_D8.0mm_P2.50mm
FB1: 100 @ 100 MHz; L_0805_2012Metric
H1, H2, H3, H4: MountingHole_Pad; MountingHole_3.2mm_M3_Pad_Via
J1: Bit 0-7; JST_XH_B8B-XH-A_1x08_P2.50mm_Vertical
J2: Bit 8-15; JST_XH_B8B-XH-A_1x08_P2.50mm_Vertical
J3: Bit 16-23; JST_XH_B8B-XH-A_1x08_P2.50mm_Vertical
J4: Bit 24-31; JST_XH_B8B-XH-A_1x08_P2.50mm_Vertical
J5: esp8266; PinSocket_2x04_P2.54mm_Vertical
J6: touch screen; JST_XH_B5B-XH-A_1x05_P2.50mm_Vertical
J7: sd card; JST_XH_B4B-XH-A_1x04_P2.50mm_Vertical
J8: lcd screen; JST_XH_B9B-XH-A_1x09_P2.50mm_Vertical
J9: Power; TerminalBlock_bornier-2_P5.08mm
R1: 00; R_0402_1005Metric
R2: 08; R_0402_1005Metric
R3: 10; R_0402_1005Metric
R4: 18; R_0402_1005Metric
R5: 01; R_0402_1005Metric
R6: 09; R_0402_1005Metric
R7: 11; R_0402_1005Metric
R8: 19; R_0402_1005Metric
R9: 02; R_0402_1005Metric
R10: 0A; R_0402_1005Metric
R11: 12; R_0402_1005Metric
R12: 1A; R_0402_1005Metric
R13: 03; R_0402_1005Metric
R14: 0B; R_0402_1005Metric
R15: 13; R_0402_1005Metric
R16: 1B; R_0402_1005Metric
R17: 04; R_0402_1005Metric
R18: 0C; R_0402_1005Metric
R19: 14; R_0402_1005Metric
R20: 1C; R_0402_1005Metric
R21: 05; R_0402_1005Metric
R22: 0D; R_0402_1005Metric
R23: 15; R_0402_1005Metric
R24: 1D; R_0402_1005Metric
R25: 06; R_0402_1005Metric
R26: 0E; R_0402_1005Metric
R27: 16; R_0402_1005Metric
R28: 1E; R_0402_1005Metric
R29: 07; R_0402_1005Metric
R30: 0F; R_0402_1005Metric
R31: 17; R_0402_1005Metric
R32: 1F; R_0402_1005Metric
U1, U2, U3, U4: 74AHC595; SOIC-16_3.9x9.9mm_P1.27mm
U5: AMS1117-3.3; SOT-223-3_TabPin2
U6: Teensy4.0; Teensy40hdr

Connections:
+3V3: C8.1, J5.4, J5.8, U5.2 (VO)
/BCK: U1.11 (SRCLK), U2.11 (SRCLK), U3.11 (SRCLK), U4.11 (SRCLK), U6.12 (10_CS_MQSR)
/DIN: U1.14 (SER), U6.10 (8_TX2_IN1)
/ESP_RESET: J5.6, U6.21 (14_A0_TX3_SPDIF_OUT)
/ESP_RX: J5.7, U6.3 (1_TX1_CTX2_MISO1)
/ESP_TX: J5.2, U6.2 (0_RX1_CRX2_CS1)
/LCD_CS: J8.6, U6.22 (15_A1_RX3_SPDIF_IN)
/LCD_DC: J8.5, U6.27 (20_A6_TX5_LRCLK1)
/LCD_LED: J8.3, U6.29 (22_A8_CTX1)
/LCD_RESET: J8.4, U6.28 (21_A7_RX5_BCLK1)
/MISO: J6.4, J7.3, J8.8, U6.14 (12_MISO_MQSL)
/MOSI: J6.3, J7.2, J8.7, U6.13 (11_MOSI_CTX1)
/SCK: J6.5, J7.4, J8.9, U6.20 (13_SCK_CRX1_LED)
/SD_CS: J7.1, U6.24 (17_A3_TX4_SDA1)
/T_CS: J6.2, U6.25 (18_A4_SDA0)
/T_IRQ: J6.1, U6.26 (19_A5_SCL0)
/WCK: U1.12 (RCLK), U2.12 (RCLK), U3.12 (RCLK), U4.12 (RCLK), U6.11 (9_OUT1C)
GND: C1.2, C2.2, C3.2, C4.2, C5.2, C6.2, C7.2, C8.2, C9.2, H1.1, H2.1, H3.1, H4.1, J5.1, J8.2, J9.2, U1.8 (GND), U1.13 (~OE), U2.8 (GND), U2.13 (~OE), U3.8 (GND), U3.13 (~OE), U4.8 (GND), U4.13 (~OE), U5.1 (GND), U6.1 (GND), U6.32 (GND)
unnamed 18: C7.1, FB1.1, U5.3 (VI); also elsewhere on the board
unnamed: J1.1, R1.1
unnamed: J1.2, R5.1
unnamed: J1.3, R9.1
unnamed: J1.4, R13.1
unnamed: J1.5, R17.1
unnamed: J1.6, R21.1
unnamed: J1.7, R25.1
unnamed: J1.8, R29.1
unnamed: J2.1, R2.1
unnamed: J2.2, R6.1
unnamed: J2.3, R10.1
unnamed: J2.4, R14.1
unnamed: J2.5, R18.1
unnamed: J2.6, R22.1
unnamed: J2.7, R26.1
unnamed: J2.8, R30.1
unnamed: J3.1, R3.1
unnamed: J3.2, R7.1
unnamed: J3.3, R11.1
unnamed: J3.4, R15.1
unnamed: J3.5, R19.1
unnamed: J3.6, R23.1
unnamed: J3.7, R27.1
unnamed: J3.8, R31.1
unnamed: J4.1, R4.1
unnamed: J4.2, R8.1
unnamed: J4.3, R12.1
unnamed: J4.4, R16.1
unnamed: J4.5, R20.1
unnamed: J4.6, R24.1
unnamed: J4.7, R28.1
unnamed: J4.8, R32.1
unnamed: R1.2, U1.15 (QA)
unnamed: R2.2, U2.15 (QA)
unnamed: R3.2, U3.15 (QA)
unnamed: R4.2, U4.15 (QA)
unnamed: R5.2, U1.1 (QB)
unnamed: R6.2, U2.1 (QB)
unnamed: R7.2, U3.1 (QB)
unnamed: R8.2, U4.1 (QB)
unnamed: R9.2, U1.2 (QC)
unnamed: R10.2, U2.2 (QC)
unnamed: R11.2, U3.2 (QC)
unnamed: R12.2, U4.2 (QC)
unnamed: R13.2, U1.3 (QD)
unnamed: R14.2, U2.3 (QD)
unnamed: R15.2, U3.3 (QD)
unnamed: R16.2, U4.3 (QD)
unnamed: R17.2, U1.4 (QE)
unnamed: R18.2, U2.4 (QE)
unnamed: R19.2, U3.4 (QE)
unnamed: R20.2, U4.4 (QE)
unnamed: R21.2, U1.5 (QF)
unnamed: R22.2, U2.5 (QF)
unnamed: R23.2, U3.5 (QF)
unnamed: R24.2, U4.5 (QF)
unnamed: R25.2, U1.6 (QG)
unnamed: R26.2, U2.6 (QG)
unnamed: R27.2, U3.6 (QG)
unnamed: R28.2, U4.6 (QG)
unnamed: R29.2, U1.7 (QH)
unnamed: R30.2, U2.7 (QH)
unnamed: R31.2, U3.7 (QH)
unnamed: R32.2, U4.7 (QH)
unnamed: U1.9 (QH'), U2.14 (SER)
unnamed: U2.9 (QH'), U3.14 (SER)
unnamed: U3.9 (QH'), U4.14 (SER)
VCC: C1.1, C2.1, C3.1, C4.1, C5.1, C6.1, C9.1, FB1.2, J8.1, J9.1, U1.10 (~SRCLR), U1.16 (VCC), U2.10 (~SRCLR), U2.16 (VCC), U3.10 (~SRCLR), U3.16 (VCC), U4.10 (~SRCLR), U4.16 (VCC), U6.33 (VIN); also elsewhere on the board

Notes on the sheet:
3v3 LDO
high speed 32 bit shift register
decoupling
grounded mounting holes

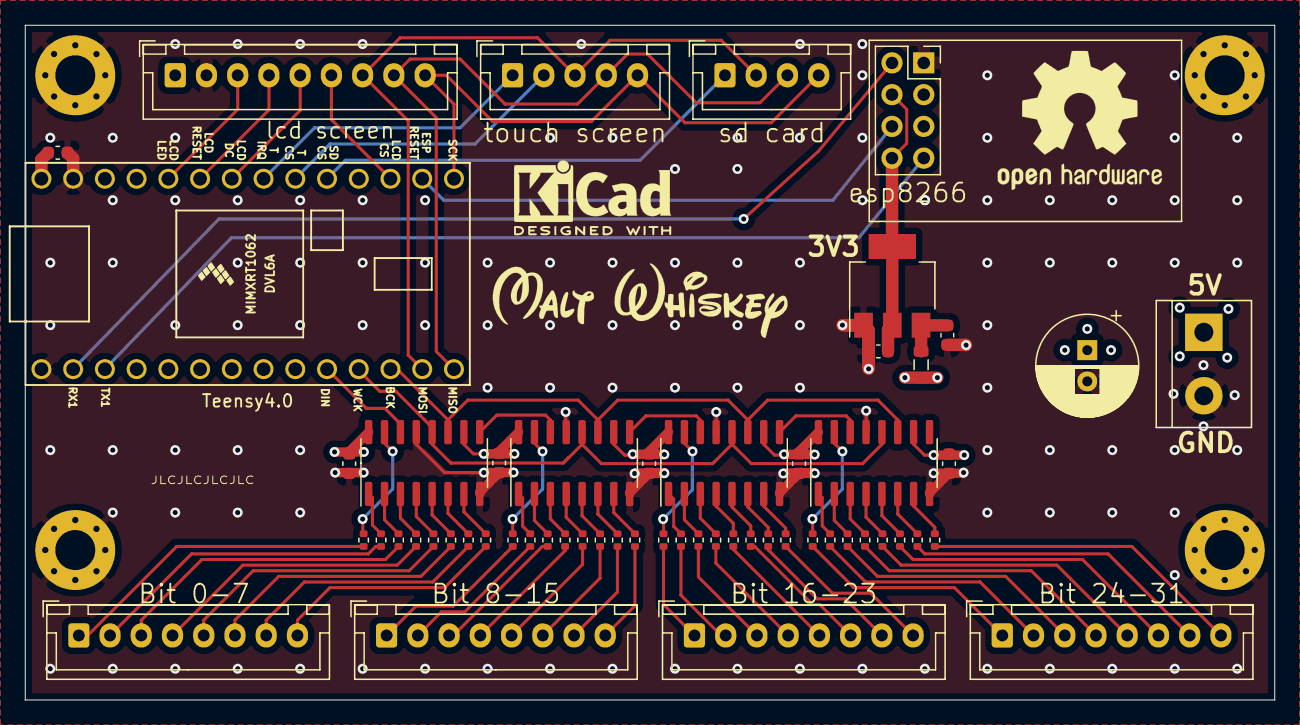
[picture p29: board Electronics/32Bit shift register v2/32Bit shift register.kicad_pcb from above]

Board: 4 copper layers, 100.0 x 54.0 mm, 61 parts (0 on the bottom side), 87 nets.

Other parts of the board:
FB: 100 @ 100 MHz; L_0805_2012Metric

Their connections:
unnamed 18: FB.1; also elsewhere on the board
VCC: FB.2; also elsewhere on the board
