MaltWhiskey/Mega-Cube/Electronics/32Bit shift register/32Bit shift register.kicad_pcb

## KiCad design Electronics/32Bit shift register/32Bit shift register.kicad_pcb (2020-12-27, an earlier design)

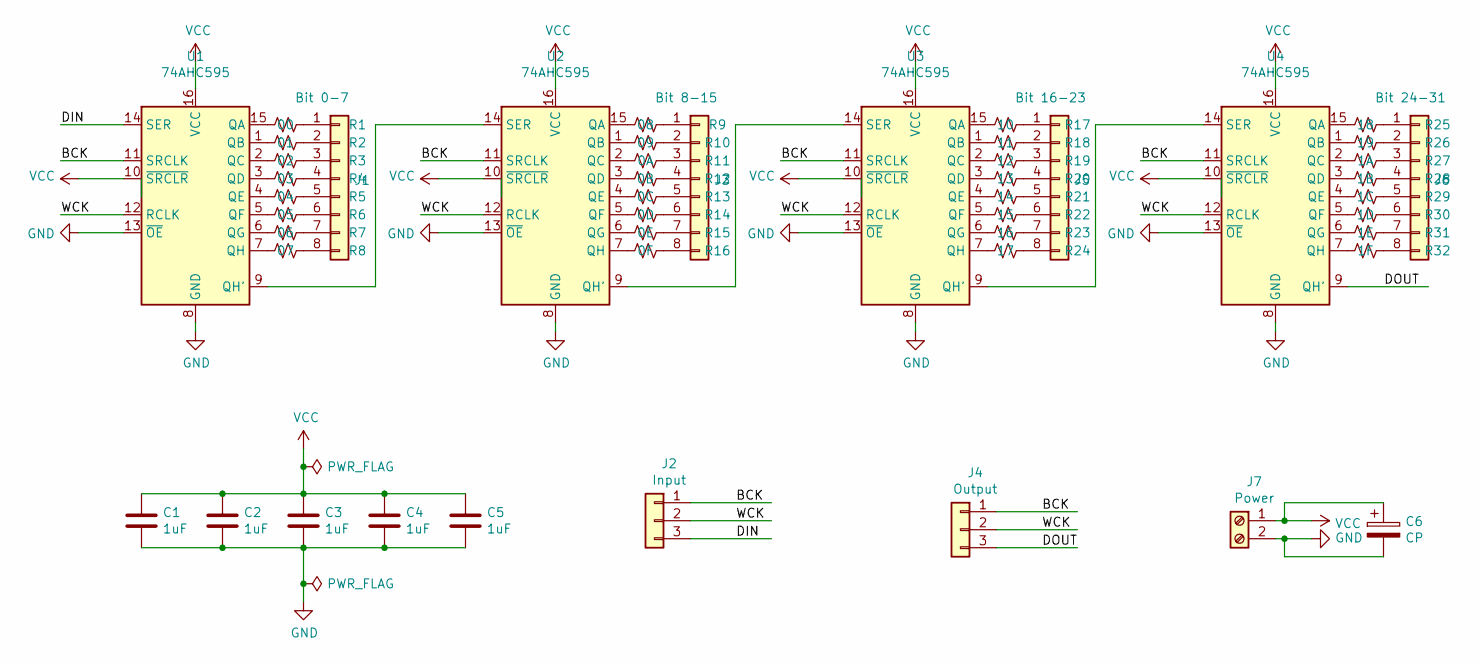
[picture p30: schematic 32Bit shift register.sch, High speed 32 Bit Shift register]

Parts:
C1, C2, C3, C4, C5: 1uF; C_Disc_D5.0mm_W2.5mm_P2.50mm
C6: CP; CP_Radial_D8.0mm_P2.50mm
J1: Bit 0-7; IDC-Header_2x04_P2.54mm_Vertical
J2: Input; PinHeader_1x03_P2.54mm_Vertical
J3: Bit 8-15; IDC-Header_2x04_P2.54mm_Vertical
J4: Output; PinHeader_1x03_P2.54mm_Vertical
J5: Bit 16-23; IDC-Header_2x04_P2.54mm_Vertical
J6: Bit 24-31; IDC-Header_2x04_P2.54mm_Vertical
J7: Power; TerminalBlock_bornier-2_P5.08mm
R1: 00; R_0805_2012Metric_Pad1.20x1.40mm_HandSolder
R2: 01; R_0805_2012Metric_Pad1.20x1.40mm_HandSolder
R3: 02; R_0805_2012Metric_Pad1.20x1.40mm_HandSolder
R4: 03; R_0805_2012Metric_Pad1.20x1.40mm_HandSolder
R5: 04; R_0805_2012Metric_Pad1.20x1.40mm_HandSolder
R6: 05; R_0805_2012Metric_Pad1.20x1.40mm_HandSolder
R7: 06; R_0805_2012Metric_Pad1.20x1.40mm_HandSolder
R8: 07; R_0805_2012Metric_Pad1.20x1.40mm_HandSolder
R9: 08; R_0805_2012Metric_Pad1.20x1.40mm_HandSolder
R10: 09; R_0805_2012Metric_Pad1.20x1.40mm_HandSolder
R11: 0A; R_0805_2012Metric_Pad1.20x1.40mm_HandSolder
R12: 0B; R_0805_2012Metric_Pad1.20x1.40mm_HandSolder
R13: 0C; R_0805_2012Metric_Pad1.20x1.40mm_HandSolder
R14: 0D; R_0805_2012Metric_Pad1.20x1.40mm_HandSolder
R15: 0E; R_0805_2012Metric_Pad1.20x1.40mm_HandSolder
R16: 0F; R_0805_2012Metric_Pad1.20x1.40mm_HandSolder
R17: 10; R_0805_2012Metric_Pad1.20x1.40mm_HandSolder
R18: 11; R_0805_2012Metric_Pad1.20x1.40mm_HandSolder
R19: 12; R_0805_2012Metric_Pad1.20x1.40mm_HandSolder
R20: 13; R_0805_2012Metric_Pad1.20x1.40mm_HandSolder
R21: 14; R_0805_2012Metric_Pad1.20x1.40mm_HandSolder
R22: 15; R_0805_2012Metric_Pad1.20x1.40mm_HandSolder
R23: 16; R_0805_2012Metric_Pad1.20x1.40mm_HandSolder
R24: 17; R_0805_2012Metric_Pad1.20x1.40mm_HandSolder
R25: 18; R_0805_2012Metric_Pad1.20x1.40mm_HandSolder
R26: 19; R_0805_2012Metric_Pad1.20x1.40mm_HandSolder
R27: 1A; R_0805_2012Metric_Pad1.20x1.40mm_HandSolder
R28: 1B; R_0805_2012Metric_Pad1.20x1.40mm_HandSolder
R29: 1C; R_0805_2012Metric_Pad1.20x1.40mm_HandSolder
R30: 1D; R_0805_2012Metric_Pad1.20x1.40mm_HandSolder
R31: 1E; R_0805_2012Metric_Pad1.20x1.40mm_HandSolder
R32: 1F; R_0805_2012Metric_Pad1.20x1.40mm_HandSolder
U1, U2, U3, U4: 74AHC595; DIP-16_W7.62mm_LongPads

Connections:
/BCK: J2.1, J4.1, U1.11 (SRCLK), U2.11 (SRCLK), U3.11 (SRCLK), U4.11 (SRCLK)
/DIN: J2.3, U1.14 (SER)
/DOUT: J4.3, U4.9 (QH')
/WCK: J2.2, J4.2, U1.12 (RCLK), U2.12 (RCLK), U3.12 (RCLK), U4.12 (RCLK)
GND: C1.2, C2.2, C3.2, C4.2, C5.2, C6.2, J7.2, U1.8 (GND), U1.13 (~OE), U2.8 (GND), U2.13 (~OE), U3.8 (GND), U3.13 (~OE), U4.8 (GND), U4.13 (~OE)
unnamed: J1.1, R1.1
unnamed: J1.2, R2.1
unnamed: J1.3, R3.1
unnamed: J1.4, R4.1
unnamed: J1.5, R5.1
unnamed: J1.6, R6.1
unnamed: J1.7, R7.1
unnamed: J1.8, R8.1
unnamed: J3.1, R9.1
unnamed: J3.2, R10.1
unnamed: J3.3, R11.1
unnamed: J3.4, R12.1
unnamed: J3.5, R13.1
unnamed: J3.6, R14.1
unnamed: J3.7, R15.1
unnamed: J3.8, R16.1
unnamed: J5.1, R17.1
unnamed: J5.2, R18.1
unnamed: J5.3, R19.1
unnamed: J5.4, R20.1
unnamed: J5.5, R21.1
unnamed: J5.6, R22.1
unnamed: J5.7, R23.1
unnamed: J5.8, R24.1
unnamed: J6.1, R25.1
unnamed: J6.2, R26.1
unnamed: J6.3, R27.1
unnamed: J6.4, R28.1
unnamed: J6.5, R29.1
unnamed: J6.6, R30.1
unnamed: J6.7, R31.1
unnamed: J6.8, R32.1
unnamed: R1.2, U1.15 (QA)
unnamed: R2.2, U1.1 (QB)
unnamed: R3.2, U1.2 (QC)
unnamed: R4.2, U1.3 (QD)
unnamed: R5.2, U1.4 (QE)
unnamed: R6.2, U1.5 (QF)
unnamed: R7.2, U1.6 (QG)
unnamed: R8.2, U1.7 (QH)
unnamed: R9.2, U2.15 (QA)
unnamed: R10.2, U2.1 (QB)
unnamed: R11.2, U2.2 (QC)
unnamed: R12.2, U2.3 (QD)
unnamed: R13.2, U2.4 (QE)
unnamed: R14.2, U2.5 (QF)
unnamed: R15.2, U2.6 (QG)
unnamed: R16.2, U2.7 (QH)
unnamed: R17.2, U3.15 (QA)
unnamed: R18.2, U3.1 (QB)
unnamed: R19.2, U3.2 (QC)
unnamed: R20.2, U3.3 (QD)
unnamed: R21.2, U3.4 (QE)
unnamed: R22.2, U3.5 (QF)
unnamed: R23.2, U3.6 (QG)
unnamed: R24.2, U3.7 (QH)
unnamed: R25.2, U4.15 (QA)
unnamed: R26.2, U4.1 (QB)
unnamed: R27.2, U4.2 (QC)
unnamed: R28.2, U4.3 (QD)
unnamed: R29.2, U4.4 (QE)
unnamed: R30.2, U4.5 (QF)
unnamed: R31.2, U4.6 (QG)
unnamed: R32.2, U4.7 (QH)
unnamed: U1.9 (QH'), U2.14 (SER)
unnamed: U2.9 (QH'), U3.14 (SER)
unnamed: U3.9 (QH'), U4.14 (SER)
VCC: C1.1, C2.1, C3.1, C4.1, C5.1, C6.1, J7.1, U1.10 (~SRCLR), U1.16 (VCC), U2.10 (~SRCLR), U2.16 (VCC), U3.10 (~SRCLR), U3.16 (VCC), U4.10 (~SRCLR), U4.16 (VCC)

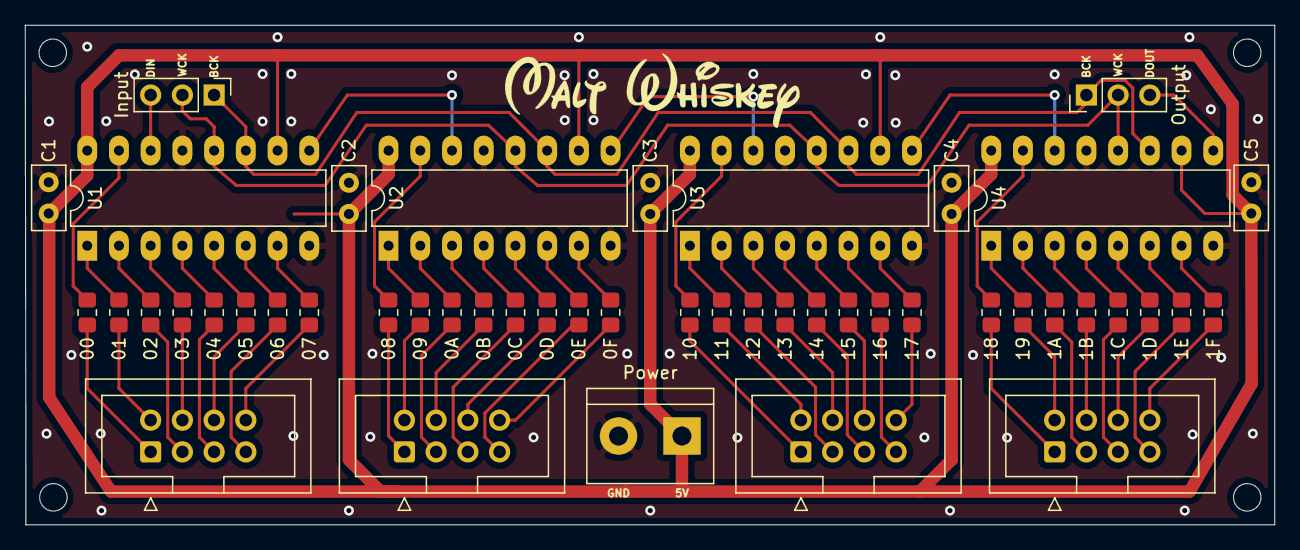
[picture p31: board Electronics/32Bit shift register/32Bit shift register.kicad_pcb from above]

Board: 2 copper layers, 100.1 x 40.0 mm, 48 parts (0 on the bottom side), 73 nets.
