MaltWhiskey/Mega-Cube/Software/LED Display/src/core/Display.cpp

#include "Display.h"

#include <Arduino.h>

/*------------------------------------------------------------------------------
 * DISPLAY CLASS
 *----------------------------------------------------------------------------*/
volatile uint8_t Display::dmaBuffer = 0;
volatile boolean Display::displayAvailable = true;
DMAMEM uint32_t Display::dmaBufferData[2][BITCOUNT * LEDCOUNT] = {};
DMAMEM uint32_t Display::dmaBufferHigh[1] = {0xFFFFFFFF};
DMAMEM uint32_t Display::dmaBufferLow[50] = {};
DMAChannel Display::dmaChannel[2];
DMASetting Display::dmaSetting[6];
uint8_t Display::motionBlur = 240;
uint8_t Display::brightness = 255;
uint32_t Display::cubeBuffer = 0;
DMAMEM Color Display::cube[2][width][height][depth];

void Display::begin() {
  setupRAM();
  setupPLL();
  setupFIO();
  setupDMA();
}

// DMAMEM can't be (static) initialized, need to do this in code
void Display::setupRAM(void) {
  memset(dmaBufferData, 0, sizeof(dmaBufferData));
  memset(dmaBufferHigh, -1, sizeof(dmaBufferHigh));
  memset(dmaBufferLow, 0, sizeof(dmaBufferLow));
  memset(cube, 0, sizeof(cube));
  arm_dcache_flush(dmaBufferData, sizeof(dmaBufferData));
  arm_dcache_flush(dmaBufferHigh, sizeof(dmaBufferHigh));
  arm_dcache_flush(dmaBufferLow, sizeof(dmaBufferLow));
}
// Triggered after all led data is sent but before reset/latch
void Display::displayReady(void) {
  // First clear the interrupt flag to avoid retriggering
  dmaChannel[0].clearInterrupt();
  // Swap dma buffer if a new one is available
  if (!displayAvailable) {
    // The prep buffer becomes the dma buffer and visa versa
    dmaBuffer = 1 - dmaBuffer;
    // Write cached data to memory before dma transfer (DMAMEM)
    arm_dcache_flush(dmaBufferData[dmaBuffer], sizeof(dmaBufferData[0]));
    dmaSetting[0].sourceBuffer(dmaBufferData[dmaBuffer],
                               sizeof(dmaBufferData[0]));
    dmaSetting[4].sourceBuffer(dmaBufferData[dmaBuffer],
                               sizeof(dmaBufferData[0]));
  }
  // The display is available to accept cube data
  displayAvailable = true;
}

// Notifies the display that a new frame is ready for displaying. Transfer
// the cube data to the prep buffer and enable the interrupt to swap the
// buffers.
//
// Note : In principle every 24 bit of led data (3 bytes) is rotated and
// the 3 bytes become bits in 24 bytes with offset chn. Maybe this can be
// made non-blocking using the pixel pipeline (pxp)?
//
// Maybe the rotate left can be implemented in assembly? Not sure if the
// compiler is smart enough to optimize the shifts as a rotation.
void Display::update() {
  if (displayAvailable) {
    uint32_t *prepBuffer = dmaBufferData[1 - dmaBuffer];
    memset(prepBuffer, 0, sizeof(dmaBufferData[0]));
    for (uint8_t x = 0; x < width; x++) {
      for (uint8_t y = 0; y < height; y++) {
        uint8_t led = 0x7F - (x << 4 & 0x30) - (((0x10 - (x & 1)) ^ y) & 0x0F);
        for (uint8_t z = 0; z < depth; z++) {
          led = 0x7F - led;
          uint32_t *offset = prepBuffer + led * BITCOUNT;
          uint8_t chn = (x >> 1 & 0x0E) + (z << 1 & 0xF8) + (z >> 1 & 1);
          uint32_t value = cube[cubeBuffer][x][y][z]
                               .blend(motionBlur, cube[1 - cubeBuffer][x][y][z])
                               .bits();
          value = (value << (1 + chn)) | (value >> (31 - chn));
          uint32_t mask = 1 << chn;
          for (uint8_t i = 0; i < BITCOUNT; i++) {
            *offset++ |= (value & mask);
            value = (value << 1) | (value >> 31);
          }
        }
      }
    }
    cubeBuffer = 1 - cubeBuffer;
    // Writing to the cube data is not allowed to prevent frame tearing
    displayAvailable = false;
  }
}
// Check if the display is available to accept new cube data
bool Display::available() { return displayAvailable; }
// Clear the cube so a new frame can be freshly created.
void Display::clear() { memset(cube[cubeBuffer], 0, sizeof(cube[0])); }
// Set the master display brightness value
void Display::setBrightness(const uint8_t value) { brightness = value; }
uint8_t Display::getBrightness() { return brightness; }
// Set the motion blur value
void Display::setMotionBlur(const uint8_t value) { motionBlur = value; }
uint8_t Display::getMotionBlur() { return motionBlur; }
/****************************************************************************
 * Set up PLL5 (also known as "VIDEO PLL")
 * This configures the Clock Controller Module (CCM)
 *
 * The internal pll clock is set to 24MHz, the frequency generated is
 * 24 * (DIV_SELECT + NUM/DENOM) -> 24 * (42 + 2/3) = 1024 MHz
 * 24 * (DIV_SELECT + NUM/DENOM) -> 24 * (29 + 17/27) = 711.1111111 MHz
 ***************************************************************************/
void Display::setupPLL() {
  // Before disabeling the PLL set the bypass source to the internal
  // 24MHz reference clock. See 14.6.1.6 page 1039.
  CCM_ANALOG_PLL_VIDEO_CLR = CCM_ANALOG_PLL_VIDEO_BYPASS_CLK_SRC(3) |
                             // Clear power down bit to power up the PLL
                             CCM_ANALOG_PLL_VIDEO_POWERDOWN;
  // Bypass the PLL also see 13.3.2.2.1 page 987
  CCM_ANALOG_PLL_VIDEO_SET = CCM_ANALOG_PLL_VIDEO_BYPASS;
  // Disable the Video PLL output before configurating
  CCM_ANALOG_PLL_VIDEO_CLR = CCM_ANALOG_PLL_VIDEO_ENABLE;
  // Clear dividers before setting the values
  CCM_ANALOG_PLL_VIDEO_CLR = CCM_ANALOG_PLL_VIDEO_DIV_SELECT(0x7f) |
                             CCM_ANALOG_PLL_VIDEO_POST_DIV_SELECT(3);
#if defined PL9823
  // NUM = 30 bits signed number, abs(NUM) must be less than DENOM
  CCM_ANALOG_PLL_VIDEO_NUM = 17;
  // DENOM = 30 bits unsigned number. NUM/DENOM -> fracional loop diver
  CCM_ANALOG_PLL_VIDEO_DENOM = 27;
#else
  // NUM = 30 bits signed number, abs(NUM) must be less than DENOM
  CCM_ANALOG_PLL_VIDEO_NUM = 2;
  // DENOM = 30 bits unsigned number. NUM/DENOM -> fracional loop diver
  CCM_ANALOG_PLL_VIDEO_DENOM = 3;
#endif
  // Clear dividers before setting the values
  CCM_ANALOG_MISC2_CLR = CCM_ANALOG_MISC2_VIDEO_DIV(3);
  // Post-divider for video values (0=/1, 1=/2, 2=/1, 3=/4) (2 is also
  // /1)
  CCM_ANALOG_MISC2_SET = CCM_ANALOG_MISC2_VIDEO_DIV(0);

  CCM_ANALOG_PLL_VIDEO_SET =
  // DIV_SELECT set the loop divider (27-54)
#if defined PL9823
      CCM_ANALOG_PLL_VIDEO_DIV_SELECT(29) |
#else
      CCM_ANALOG_PLL_VIDEO_DIV_SELECT(42) |
#endif
      // Divider after PLL (0=/4, 1=/2, 2=/1, 3=reserved)
      CCM_ANALOG_PLL_VIDEO_POST_DIV_SELECT(2) |
      // Enable PLL output (still bypassed)
      CCM_ANALOG_PLL_VIDEO_ENABLE;

  // Wait for the PLL to lock. Prevents random initial edges 13.3.2.2.1
  while ((CCM_ANALOG_PLL_VIDEO & CCM_ANALOG_PLL_VIDEO_LOCK) == 0) {
  }
  // Disable bypass for Video PLL once it's locked.
  CCM_ANALOG_PLL_VIDEO_CLR = CCM_ANALOG_PLL_VIDEO_BYPASS;
}
/*******************************************************************************
 * Configure flexio
 *
 * Pad settings:
 *   HYS Hysteresis enable = 0 (0=disabled, 1=enabled)
 *   PUS pull up/down config select = 0
 *     (0=100K pull down, 1=47K pull up, 2=100K pull up, 3=22K pull up)
 *   PUE Keeper select = 0 (0=keeper, 1=pull)
 *   PKE Pull keeper enable = 0 (0=disabled, 1=enabled)
 *   ODE Open drain enable = 0 (0=disabled, 1=enabled)
 *   SPEED speed = 1
 *     (0=50MHz, 1=100MHz, 2=150MHz, 3=200MHz)
 *     (Increases output driver current or reduce switching noise)
 *   DSE drive strength = x (should be impedance matched)
 *     (0 = off, 1=150/1 Ohm, 2=150/2 Ohm, 3=150/3 Ohm, ... 7=150/7 Ohm)
 *     (tr -> 5=1.70ns, 3=2.35ns, 2=3.13ns, 1=5.14ns @ SRE=0)
 *     (tr -> 5=1.06ns, 3=1.74ns, 2=2.46ns, 1=4.77ns @ SRE=1)
 *     (Transition rise and fall time are DSE & SRE dependent)
 *   SRE slew rate = 0 (0=slow, 1=fast)
 ******************************************************************************/
void Display::setupFIO() {
  *portModeRegister(DIN) |= digitalPinToBitMask(DIN);
  *portControlRegister(DIN) = IOMUXC_PAD_DSE(3) | IOMUXC_PAD_SPEED(1);
  // SION + ALT4 (FLEXIO2_FLEXIO16) (IOMUXC_SW_MUX_CTL_PAD_GPIO_B1_00)
  *portConfigRegister(DIN) = 0x14;

  *portModeRegister(WCK) |= digitalPinToBitMask(WCK);
  *portControlRegister(WCK) = IOMUXC_PAD_DSE(3) | IOMUXC_PAD_SPEED(1);
  // SION + ALT4 (FLEXIO2_FLEXIO11) (IOMUXC_SW_MUX_CTL_PAD_GPIO_B0_11)
  *portConfigRegister(WCK) = 0x14;

  *portModeRegister(BCK) |= digitalPinToBitMask(BCK);
  *portControlRegister(BCK) = IOMUXC_PAD_DSE(3) | IOMUXC_PAD_SPEED(1);
  // SION + ALT4 (FLEXIO2_FLEXIO00) (IOMUXC_SW_MUX_CTL_PAD_GPIO_B0_00)
  *portConfigRegister(BCK) = 0x14;

  // Disable flexio2 clock gate see 14.7.24 page 1087
  CCM_CCGR3 &= ~CCM_CCGR3_FLEXIO2(CCM_CCGR_ON);
  // Serial Clock Multiplexer Register 2
  CCM_CSCMR2 &= ~CCM_CSCMR2_FLEXIO2_CLK_SEL(3);
  // Derive clock from PLL5 clock 14.7.8 page 1059
  CCM_CSCMR2 |= CCM_CSCMR2_FLEXIO2_CLK_SEL(2);
  // Clock divider register pre divider
  CCM_CS1CDR &= ~CCM_CS1CDR_FLEXIO2_CLK_PRED(7);
  // Divide by (4 + 1 = 5)
  CCM_CS1CDR |= CCM_CS1CDR_FLEXIO2_CLK_PRED(4);
  // Clock divider register post divider
  CCM_CS1CDR &= ~CCM_CS1CDR_FLEXIO2_CLK_PODF(7);
  // Divide by (0 + 1 = 1)
  CCM_CS1CDR |= CCM_CS1CDR_FLEXIO2_CLK_PODF(0);
  // Enable flexio2 clock gate see 14.7.24 page 1087
  CCM_CCGR3 |= CCM_CCGR3_FLEXIO2(CCM_CCGR_ON);

  // Shifter control 50.5.1.14 page 2925
  // SHIFTER0 is configured to output on DIN = pin 8
  IMXRT_FLEXIO2_S.SHIFTCTL[0] =
      // Timer select -> TIMER0 controls logic and shift clock
      FLEXIO_SHIFTCTL_TIMSEL(0) |
      // Timer polarity -> shift on negative edge of shift clock
      FLEXIO_SHIFTCTL_TIMPOL |
      // Shifter pin configuration -> shifter pin output
      FLEXIO_SHIFTCTL_PINCFG(3) |
      // Shifter pin select FLEXIO16 pin (DIN pin)
      FLEXIO_SHIFTCTL_PINSEL(16) |
      // Shifter pin polarity -> pin is active high
      (FLEXIO_SHIFTCTL_PINPOL & 0) |
      // Shifter mode -> Transmit mode. Load SHIFTBUF contents into
      // the shifter on expiration of the Timer
      FLEXIO_SHIFTCTL_SMOD(2);
  // SHIFTERS 1-3 do not output to a pin
  IMXRT_FLEXIO2_S.SHIFTCTL[1] =
      FLEXIO_SHIFTCTL_TIMPOL | FLEXIO_SHIFTCTL_SMOD(2);
  IMXRT_FLEXIO2_S.SHIFTCTL[2] =
      FLEXIO_SHIFTCTL_TIMPOL | FLEXIO_SHIFTCTL_SMOD(2);
  IMXRT_FLEXIO2_S.SHIFTCTL[3] =
      FLEXIO_SHIFTCTL_TIMPOL | FLEXIO_SHIFTCTL_SMOD(2);

  // Shifter configuration 50.5.1.15 page 2927
  // SHIFTER0 shifts 1 bit on each clock and has SHIFTER(0+1) as source
  IMXRT_FLEXIO2_S.SHIFTCFG[0] =
      // 1-bit shift on each shift clock
      FLEXIO_SHIFTCFG_PWIDTH(0) |
      // Input source for shifter is output of Shifter N+1
      FLEXIO_SHIFTCFG_INSRC;
  // Same for shifters 1 - 3
  IMXRT_FLEXIO2_S.SHIFTCFG[1] = FLEXIO_SHIFTCFG_INSRC;
  IMXRT_FLEXIO2_S.SHIFTCFG[2] = FLEXIO_SHIFTCFG_INSRC;
  // Illegal input source for shifter 3 ??????
  IMXRT_FLEXIO2_S.SHIFTCFG[3] = FLEXIO_SHIFTCFG_INSRC;

  // Timer configuration 50.5.1.21.4 page 2935
  IMXRT_FLEXIO2_S.TIMCFG[0] =
      // Timer output is logic 1 when enabled, not affected by reset
      FLEXIO_TIMCFG_TIMOUT(0) |
      // Decrement counter on flexio clock, shift clock = timer output
      FLEXIO_TIMCFG_TIMDEC(0) |
      // Timer never resets
      FLEXIO_TIMCFG_TIMRST(0) |
      // Timer never disabled
      FLEXIO_TIMCFG_TIMDIS(0) |
      // Timer enabled on trigger high (shifter 0 status flag)
      FLEXIO_TIMCFG_TIMENA(2) |
      // Stop bit disabled
      FLEXIO_TIMCFG_TSTOP(0) |
      // Start bit disabled
      (FLEXIO_TIMCFG_TSTART & 0);
  IMXRT_FLEXIO2_S.TIMCFG[1] =
      // Timer enabled on timer N-1 enable
      FLEXIO_TIMCFG_TIMENA(1);

  // Timer control 50.5.1.20 page 2932
  // Triggered after loading SHIFTER0 from SHIFTBUF0 50.5.1.16.3 page
  // 2929 TIMER0 is configured to output on BCK = pin 10
  IMXRT_FLEXIO2_S.TIMCTL[0] =
      // Trigger select -> triggers on SHIFTER[N=0] status flag (4*N+1)
      FLEXIO_TIMCTL_TRGSEL(1) |
      // Trigger polarity -> trigger active low
      FLEXIO_TIMCTL_TRGPOL |
      // Trigger source -> internal trigger selected
      FLEXIO_TIMCTL_TRGSRC |
      // Timer pin configuration -> timer pin output
      FLEXIO_TIMCTL_PINCFG(3) |
      // Timer pin select -> FLEXIO00 (BCK on pin 10)
      FLEXIO_TIMCTL_PINSEL(0) |
      // Timer pin polarity -> active high
      (FLEXIO_TIMCTL_PINPOL & 0) |
      // Timer mode -> dual 8 bit counters baud mode
      FLEXIO_TIMCTL_TIMOD(1);
  // No trigger is used, timer is enabled on TIMER0
  // TIMER1 is configured to output on BCK = pin 10
  IMXRT_FLEXIO2_S.TIMCTL[1] =
      // Timer pin configuration -> timer pin output
      FLEXIO_TIMCTL_PINCFG(3) |
      // Timer pin select -> FLEXIO11 (WCK on pin 9)
      FLEXIO_TIMCTL_PINSEL(11) |
      // Timer pin polarity -> active high
      (FLEXIO_TIMCTL_PINPOL & 0) |
      // Timer mode -> single 16-bit counter mode
      FLEXIO_TIMCTL_TIMOD(3);

  // Timer compare 50.5.1.22 page 2937
  // The upper 8 bits configure the number of bits = (cmp[15:8] + 1) / 2
  // Upper 8 bits -> 4 x 32 bits -> 128 * 2 -> 256 - 1 = 0xFF voor 128
  // bits The lower 8 bits configure baud rate divider = (cmp[ 7:0] + 1)
  // * 2 Lower 8 bits -> (0 + 1) * 2 -> divide frequency by 2
  IMXRT_FLEXIO2_S.TIMCMP[0] = 0x0000FF00;
  // Timer compare 50.3.3.3 page 2891
  // Configure baud rate of the shift clock (cmp[15:0] + 1) * 2
  // -> (31 + 1) * 2 -> divide frequency by 64
  // When the counter equals zero and decrements the timer output
  // toggles Pulses generated -> 32 pulses of TIMER0 and 1 pulse of
  // TIMER1
  IMXRT_FLEXIO2_S.TIMCMP[1] = 0x0000001F;

  // Shiftbuffers 1 & 2 get filled by DMA later. Start with all zero's
  // to reset/latch the led's. See 50.5.1.6.3 page 2918 for DMA
  // triggering.
  IMXRT_FLEXIO2_S.SHIFTBUFBIS[0] = 0x00000000;
  IMXRT_FLEXIO2_S.SHIFTBUFBIS[1] = 0x00000000;
  IMXRT_FLEXIO2_S.SHIFTBUFBIS[2] = 0x00000000;
  IMXRT_FLEXIO2_S.SHIFTBUFBIS[3] = 0x00000000;
  // Enable DMA trigger when SHIFTBUF[1 or 2] is loaded onto the shifter
  IMXRT_FLEXIO2_S.SHIFTSDEN |= 0x06;
  // Enable flexio, SHIFTBUF[0] has been written, so TIMER0 will start
  // and other buffers are also ready so no errors in shifting data
  IMXRT_FLEXIO2_S.CTRL = FLEXIO_CTRL_FLEXEN;
}

void Display::setupDMA() {
  // TCD 0 transfers the active dma buffer data to SHIFTBUF[1].
  dmaSetting[0].sourceBuffer(dmaBufferData[dmaBuffer],
                             sizeof(dmaBufferData[0]));
  dmaSetting[0].destination(IMXRT_FLEXIO2_S.SHIFTBUFBIS[1]);
  dmaSetting[0].replaceSettingsOnCompletion(dmaSetting[1]);
  // Synchronize buffer swapping with dma transfer to avoid display
  // artifacts
  dmaSetting[0].interruptAtCompletion();
  // TCD 1 sets SHIFTBUF[0] Low. The DMA channel is triggered by FlexIO
  // shifter 1. A write to SHIFTBUF[0] doesn't clear this trigger. The
  // DMA channel is triggered again upon completion of TCD1
  dmaSetting[1].sourceBuffer(dmaBufferLow, 4);
  dmaSetting[1].destination(IMXRT_FLEXIO2_S.SHIFTBUFBIS[0]);
  dmaSetting[1].replaceSettingsOnCompletion(dmaSetting[2]);
  // TCD 2 sets SHIFTBUF[1] to 0. This is to reset the leds.
  // We need >50us of zeros so adjust buffer size accordingly.
  dmaSetting[2].sourceBuffer(dmaBufferLow, sizeof(dmaBufferLow));
  dmaSetting[2].destination(IMXRT_FLEXIO2_S.SHIFTBUFBIS[1]);
  dmaSetting[2].replaceSettingsOnCompletion(dmaSetting[3]);
  // TCD 3 sets SHIFTBUF[0] High. Triggers again.
  dmaSetting[3].sourceBuffer(dmaBufferHigh, 4);
  dmaSetting[3].destination(IMXRT_FLEXIO2_S.SHIFTBUFBIS[0]);
  dmaSetting[3].replaceSettingsOnCompletion(dmaSetting[0]);

  // TCD 4 = TCD 0 for SHIFBUF[2]
  dmaSetting[4].sourceBuffer(dmaBufferData[dmaBuffer],
                             sizeof(dmaBufferData[0]));
  dmaSetting[4].destination(IMXRT_FLEXIO2_S.SHIFTBUFBIS[2]);
  dmaSetting[4].replaceSettingsOnCompletion(dmaSetting[5]);
  // TCD 5 = TCD 0 for SHIFBUF[2]
  dmaSetting[5].sourceBuffer(dmaBufferLow, sizeof(dmaBufferLow));
  dmaSetting[5].destination(IMXRT_FLEXIO2_S.SHIFTBUFBIS[2]);
  dmaSetting[5].replaceSettingsOnCompletion(dmaSetting[4]);

  // Initialize both DMA channels
  dmaChannel[0].disable();
  dmaChannel[1].disable();
  // Start with the reset/latch signal, so we can begin "fresh"
  dmaChannel[0] = dmaSetting[2];
  dmaChannel[1] = dmaSetting[5];
  dmaChannel[0].triggerAtHardwareEvent(DMAMUX_SOURCE_FLEXIO2_REQUEST1);
  // Attach interrupt to dma channel 0. The interrupt is enabled in
  // update and disabled again in the ISR.
  dmaChannel[0].attachInterrupt(&displayReady);
  // Bit pattern for PL9823 leds: High, Data, Data, Low
  // Bit pattern for WS2812 leds: High, Data, Low, Low
#if defined PL9823
  // Quick Fix: Don't trigger DMA for WS2812, this keeps 2nd data pulse
  // low
  dmaChannel[1].triggerAtHardwareEvent(DMAMUX_SOURCE_FLEXIO2_REQUEST3);
#endif
  dmaChannel[0].enable();
  dmaChannel[1].enable();
}
