MaltWhiskey/Mega-Cube/(commit log)

2021-04-24 new test
    [32Bit shift register-B_Cu.gbr, 32Bit shift register-B_Mask.gbr, 32Bit shift register-B_Paste.gbr, 32Bit shift register-B_SilkS.gbr, 32Bit shift register-Edge_Cuts.gbr, 32Bit shift register-F_Cu.gbr, 32Bit shift register-F_Mask.gbr, 32Bit shift register-F_Paste.gbr]
2021-11-04 Added STL files
    [32Bit shift register-B_Cu.gbr, 32Bit shift register-B_Mask.gbr, 32Bit shift register-B_Paste.gbr, 32Bit shift register-B_SilkS.gbr, 32Bit shift register-Edge_Cuts.gbr, 32Bit shift register-F_Cu.gbr, 32Bit shift register-F_Mask.gbr, 32Bit shift register-F_Paste.gbr]
2021-11-05 Fixed overhang
    [PCB.stl]
2021-11-19 Quaternion and Perlin Noise
    [Animation.cpp, Arrows.h, Atoms.h, Color.cpp, Config.h, Display.cpp, Display.h]
2021-12-08 Added Wifi and LCD (SPI and FLEXIO conflict?)
2022-07-15 Big Update
    [1 Tower box.stl, Mega-Cube-Board(om en om).kicad_sch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]
2022-08-03 fixed timer
2022-08-04 button fix
2022-08-04 dma fix
2023-08-31 Instructions for PCB added
